Mr-What/Tetra3D/doc/Notes/NOTES.md

# Tilted Delta Development Notes
[Calibration Log](https://docs.google.com/spreadsheets/d/1F8SSiFC5vxzJGwmjgO5lJFe-6YIsopfEGAam5U8VZzw/edit?usp=sharing "Calibration Log")

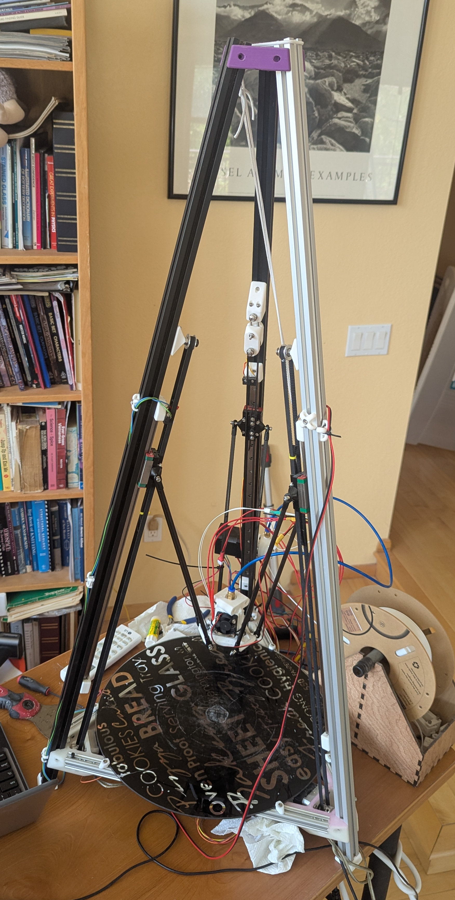
[picture p1: doc/Notes/tetrahedral3Dprinter.jpg]
Tetrahedral 3D printer Initial prototype, circa Jluy 2026


## Added tilted_delta kinematics to klipper
Initial build had a switch mounted on effector, which could
be considered to be a zero offset bed probe.
New kinematics got running in Klipper.
[Bed probe running under Klipper](https://youtu.be/T_cUYRJ55_Q "Bed probe running under Klipper").
I am maintaining a [branch of klipper](https://github.com/Mr-What/klipper/tree/tilted-delta-kinematics-dev "tilted-delta-kinematics-dev branch of klipper") with the tilted_delta kinematics.

## COTS effector trial

Initial build was using a COTS effector
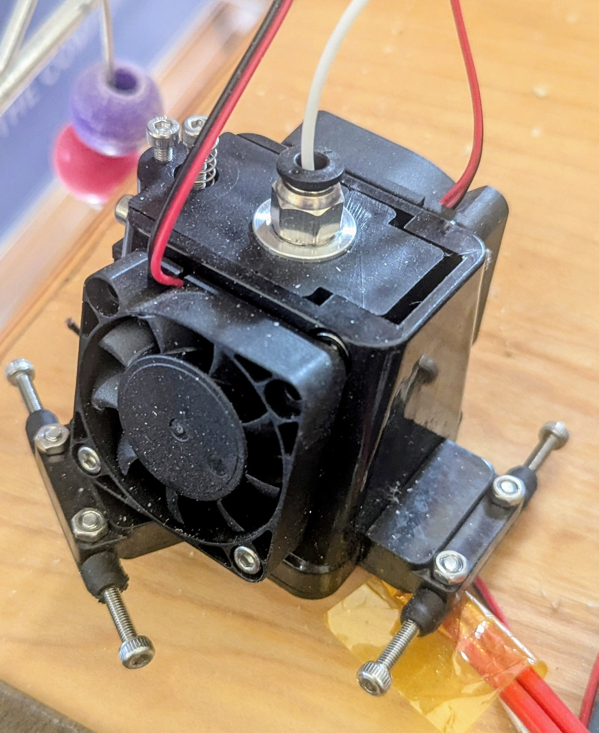
[picture p2: doc/Notes/RostockHotEnd.jpg]
COTS effector COTS Rostock/Kossel toolhead

where the hot end was mounted with a hinge, and pre-loaded with a spring.
This was not repeatable enough to use for a bed probe.

## Experimental Kinematic Mount hot-end probe

Placed hot-end on a kinematic mount,
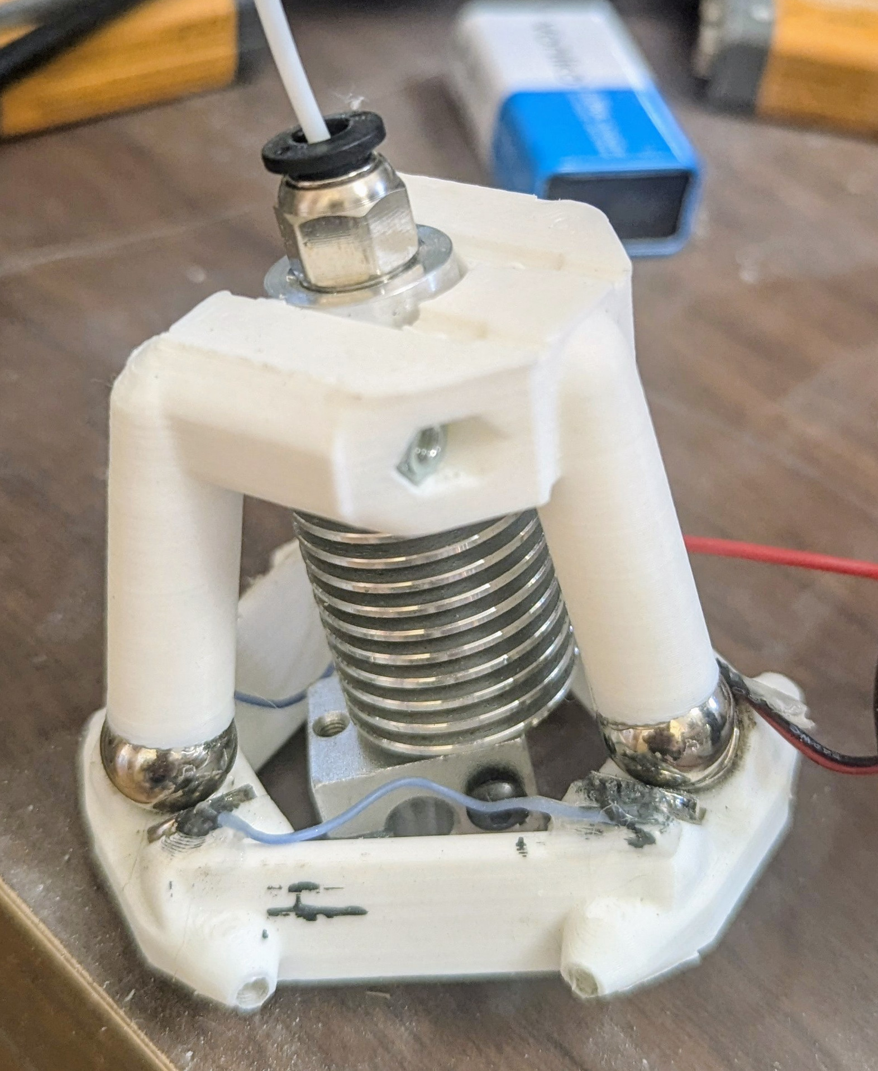
[picture p3: doc/Notes/kinEffector1.jpg]
hot-end on a kinematic mount

which was wired to detect when contact is lost on any of the six contact points.
This was made with parts on hand.
Never complete as a print head.

It seemed to work for a while, but with unpredictable results.
I measured that it took about 400g-force to release the kinematic mount.
I think that the printer is likely to flex and settle given this much force, and I expect that it gave different readings depending on probe location.
I also noted that the first probe or two were often very different to subsequent probes, which did converge.
I think that the frame stretches and moves for the first two probes before becoming repeatable.

probe pattern

Then I got a problem where probes got worse and worse as time progressed, then it would fail upon detecting a bed crash.
tilted up towards tower A as probes continue tilt gets worse over time

I installed a traditional limit switch with offset to the nozzle.
I saw the same problem.
It took a long time for me to figure out that something was wrong with stepper A.
I marked the belt and pulley at location (0,0,150).
I then ran a probe until it stopped on bed crash.
I commanded it to return to (0,0,150), and noted that the belt was around 12mm from the marked position for (0,0,150), which is very close to the amount of error needed for a bed crash.

I replaced stepper A with a slightly higher torque one, and this problem seemed to go away.
reopeatable probe pattern

Having already developed kinematic mounts,
I completed the design to hold hot end on a kinematic mount.
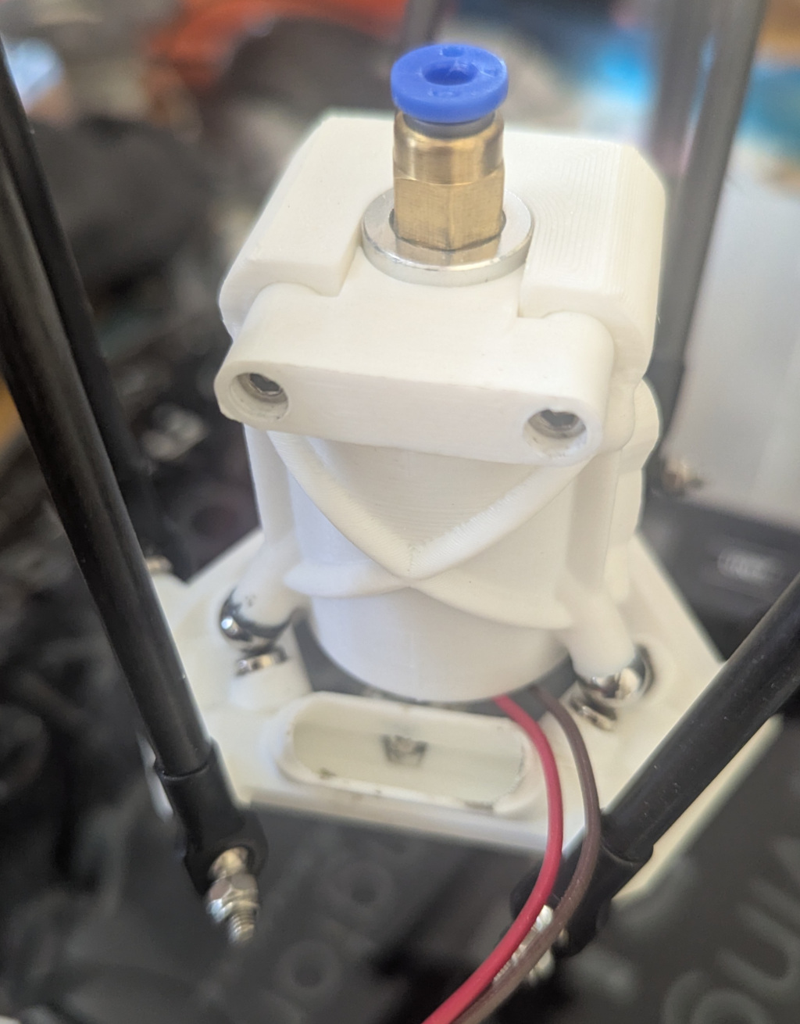
[picture p4: doc/Notes/kinEffector.jpg]
hot end on a kinematic mount

This effector has a removable probe switch and a kinematic mount for the hot end, which can be wired into a bed probe.

### 260715

I have not yet wired new complete kinematic hot end probe,
but I ran a pressure test.  It got up to about 500g, then jumped down to about 450.  I think that might be where contact was broken.
As I kept moving down, I saw it varying from 350 to 400.

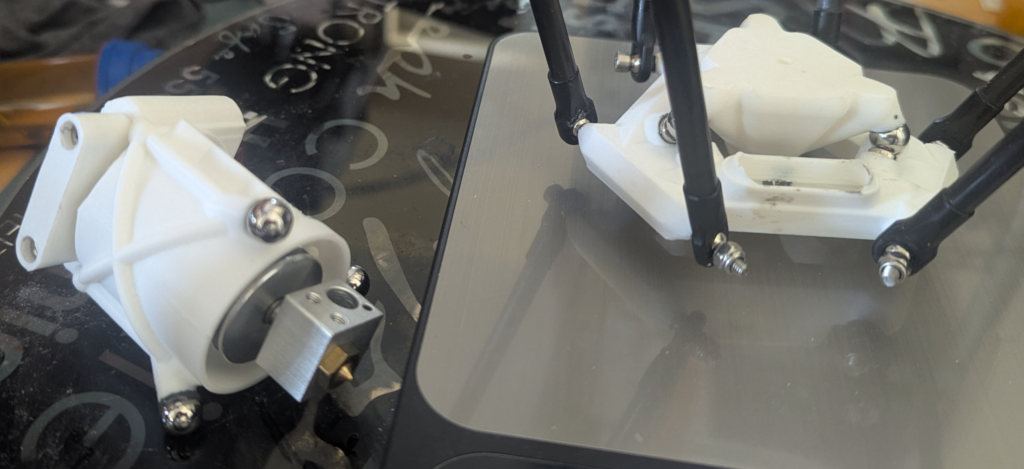
[picture p5: doc/Notes/kinProbe+hotend260715.jpg]
Kinematic probe and hot end kinematic probe with hot end removed


Repeating with the proposed proxy probe, which has likely 306 or 304 balls as opposed to 440c on the complete nozzle assembly, I think the release force is perhaps a little over 28g.
I don't know if I actually saw the release force, since it went from 0g to 28g in my shortest step of 0.025mm.
The measured force stayed about the same from there.
The mass of the probe is 16g, so I think I was seeing that
plus about 10g of magnetic pre-load. 

### 260720

Noted belt slip on stepper A, even after new motor.
In retrospect, I should have known.
Marked belt and pulley position after `G28;G0 X0 Y0 Z150`.
After a run, then `G0 X0 Y0 Z0` noted that dots did not align.
After another `G28` dots aligned on the idler but not the pulley.
The only way this could happen is if belt slipped.

Cleaned pulley, replaced belt, and installed new
idler tensioner.
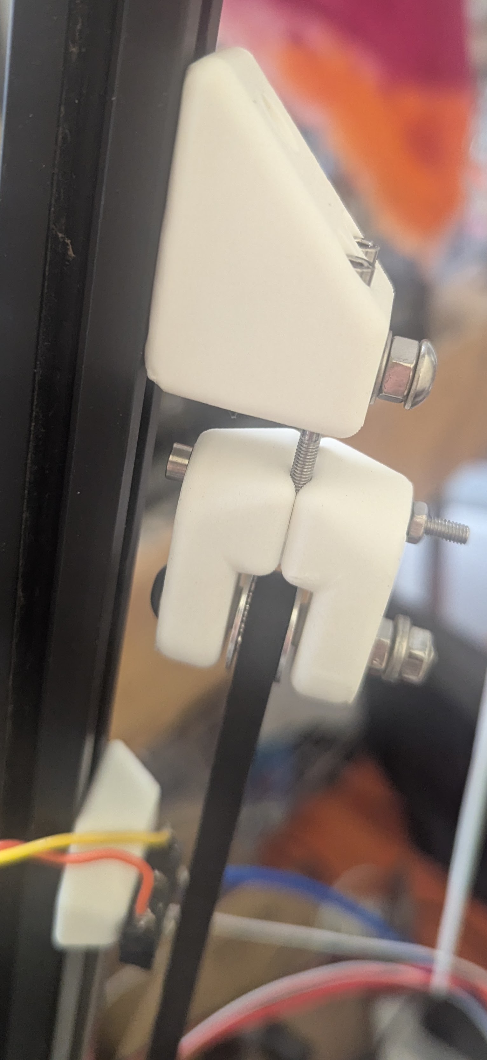
[picture p6: doc/Notes/adjustableIdler260720.jpg]
Adjustable Idler Tensioning Idler Mount

I obtained a decent probe using switch.
repeatable probe Probe repeatable, but significant tilt
It appears to be a clean tilt, indicating an error
in stepper A endstop position.
This is expected, after replacing much stepper A hardware.

Ran with zero offset setting.
Current switch offset measured at (0,-10,-2.2)
from nozzle on kinematic mounted hot end.

I plan to apply offset adjustment in analysis code.
It is not clear that typical offset application is
the best way to go with a delta.
Errors are often X-Y dependant, primarily due to un-modeled
effector tilt.
It might be better to assume bed probe is at commanded X-Y,
and accept that there will be a small Z error for the offset.
We know that we are primarily measuring build imperfections.
The plate could be assumed to be flat, but tilted to adjust.

### 260721

Could not get repeatability with light kinematic probe.

I asked perplexity for what ball materials might be available between the very strongly magnetic 440c,
and the weak magnetism of my light probe, likely a 304 or 316.
It suggested a common carbon steel, like 52100,
or ferritic stainless, like 430.

Claude notes that magnitism drops significantly with a small gap.
However, I still need conductivity, and hardness.
Perhaps I can fabricate removable (or wired) non-magnetic face covers.

### 260722

Cleaned drive pulley A, new belt, and new adjustable belt
tension devic
Did a bed level probe,
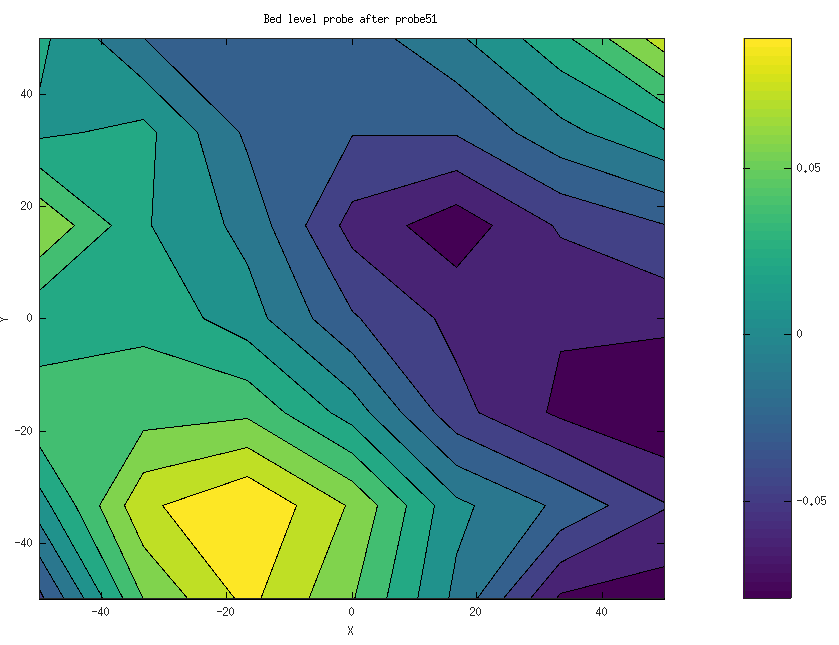
[picture p7: doc/Notes/bed51.png]
bed level probe bed level probe after probe 51

 and was able to print test pattern.
 
 ### 260724
 
Was able to do some test prints.
We need significantly different parameters for eSun PLA+ vs elegoo PLA+.
Got some decent small prints with elegoo.
Demos for Quelab re-opening tomorrow.

### 260727

Trying to get light probe as close as possible to
actual hot-end toolhead.

#### Bed Probes at (0,0)

| | |
| ---|--- |
| Nozzle catches paper | -0.425 |
| Light probe catches paper | -0.450 |
| Nozzle probe | -0.571 |
| light probe | -0.516 |

I think it makes most sense to base the offset
from where the light probe triggers to at or
slightly below where the nozzle catches paper.
How many microns thick is typical newsprint?
I am always confused by the sign for the offset,
so our offset should be +- 0.091.

### 260730

Printer was demonstrated at Quelab re-opening party
on 7/25/2026.
Work is continuing at home.

I have been having issues with the kinematic probe/sensors working.
It seems that they can reduce or go away by cleaning the contact
surfaces with isopropyl alchahol (IPA).
Acetone might be better, but it also might melt IPA or PETG.

bed mesh bed compensation probe
<!-- ![bed mesh](./bedMesh.png "bed compensation probe") -->

I am re-running probes on a bed that has adhesive on it
to print without a bed heater.
This might raise the bed surface about 0.1mm in a random
fashion.
I don't think this will be a problem for the calibration.
It is just a little extra noise.
I had been experimenting with weights on the probe to improve
contact.
I don't think it really helps.
It seems to be running OK without weight after cleaning.
The problem with weight, is although it improves downward
preload force, it is also a challenge to move laterally to
the lowest energy position.
Using the weak ferromatnetic balls, likely 304 stainless or 316,
they may not have the strength to center a weighted probe.
The problem with probes triggering premature might be
helped by cleaning contacts, reducing friction on ball to magnet face.

good probe good cal probe

### 260819

Back from renovating rental. Note:
```
   Z_offset = (Z where probe triggers) - (Z where nozzle touches bed)
```

### 260820

New switch probe.
Z at bed keeps going up, at least for a while.
Initial nozzle touch at 0.225mm, then probe went up by
perhaps .06 on repeated probes, seemed to settle at .87.
Repeat nozzle touch at .27

Re-calibrated with new probe.   Results OK.
18 parameter optimization converged.
stable results.

### 260822

Got decent bed probe:
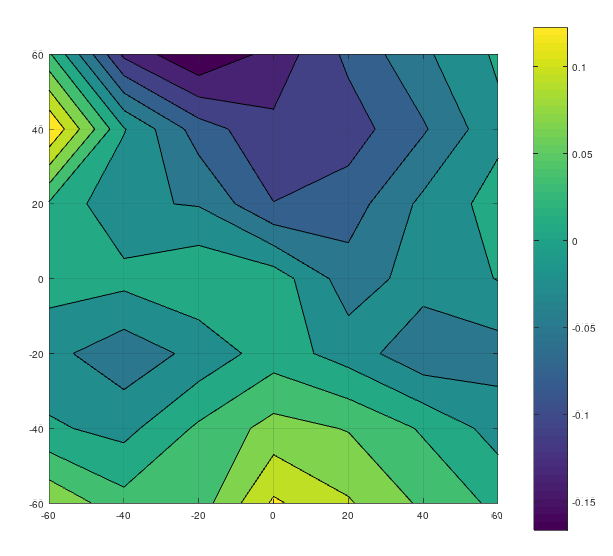
[picture p8: doc/Notes/bedMesh63.png]
bed63


XY calibration is problematic.
Printed 100mm test "cube".
Sides not straight or square.
Vertical looks pretty straight and square.

I don't want to spend too much time calibrating
this configureation.
I think the next step is to move to the shorter
arms, and go through the whole calibration process again.

### 260906

Got new shorter arms a while ago.  180mm.
They usually sell these by carbon tube length,
so 180mm would be around 210mm arm length.
Re-ordered tubes and M3 heim joints to make my own.
Re-installing old arms, will need to re-calibrate.

Printed new mounts for tghe BiQU microprobe, and the Mellow Multihead Zero device.

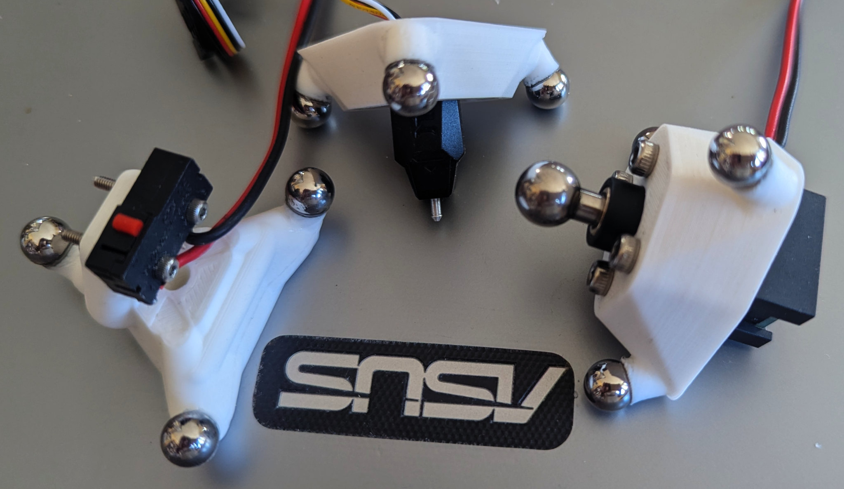
[picture p9: doc/Notes/probeTools.jpg]
New probe toolheads


### 260907

Got a very good probe from the Mellow Multihead Zero probe.
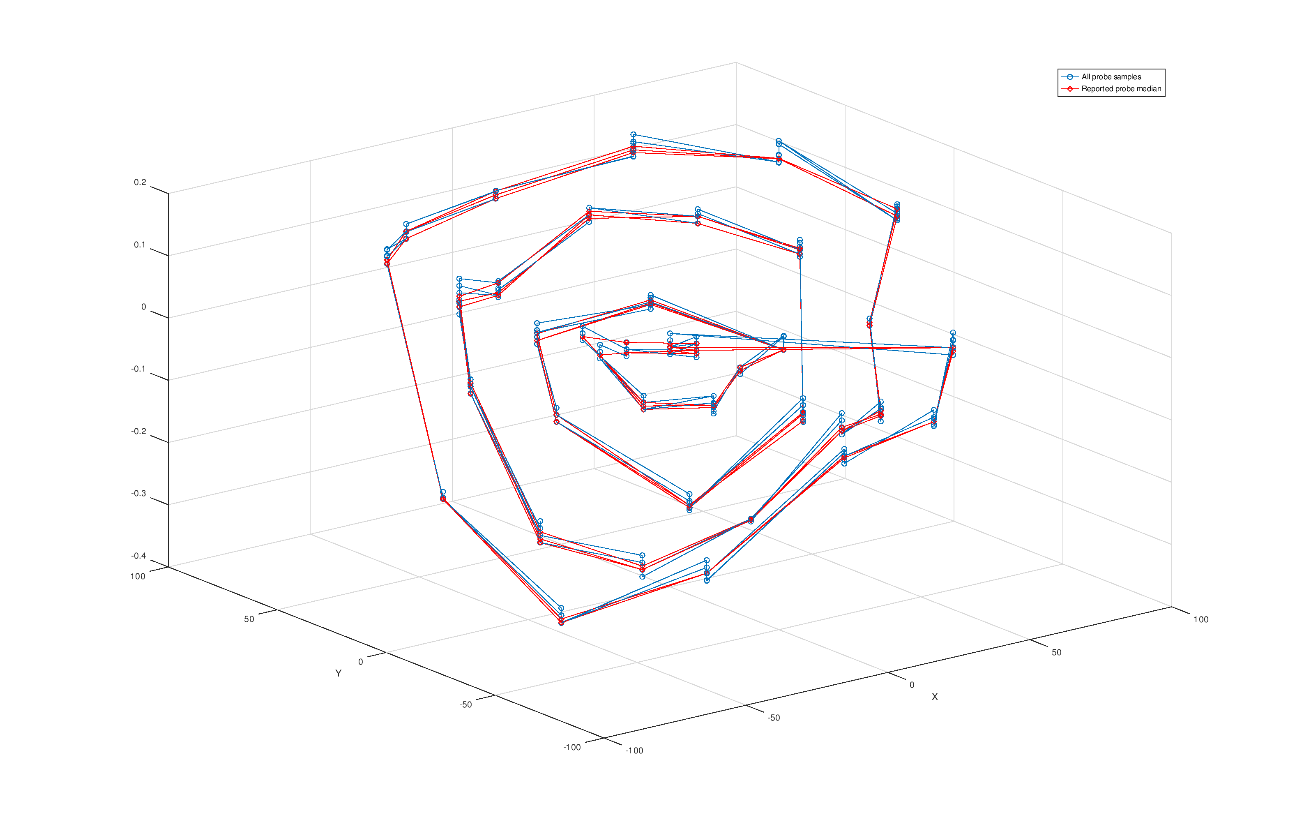
[picture p10: doc/Notes/probe64.png]
probe 64

Google is down, so notes on probe:

calAE:
```
     median=-0.05;
     StDev =  .123;
     err=0.048139;
     endstop=[480.7930, 475.5129, 476.7947];
     arm=[285.942075 , 284.944120 , 285.907718];
```

This was after re-assembling arms, so they were certainly swapped.
I expect to see change in arm settings.
Previous params:
```
   delta_angles = 209.787   330.137    89.931
   delta_radius = 169.49   169.30   169.23
   arm_lengths =  286.04   285.97   286.03
   tilt_radial =  13.775   12.526   12.783
   tilt_tangential = 0.031834  -0.346611   0.705373
   position_endstops = 480.63   476.64   477.15
```

after probing with these updates, we get:
```
z stats: [median, mean, SD] = [ -0.005 , -0.002 , 0.0510 ]
```

For future reference, probe a bed mesh like :
```
   HOME
   BED_MESH_CALIBRATE PROFILE=myMeshLabel
   SAVE_CONFIG
   ...
   BED_MESH_PROFILE LOAD=myMeshLabel
   BED_MESH_OUTPUT  # I don't know if this works
   BED_MESH_CLEAR # turn off bed level compensation
```

Results with above arm-length and endstop update were:
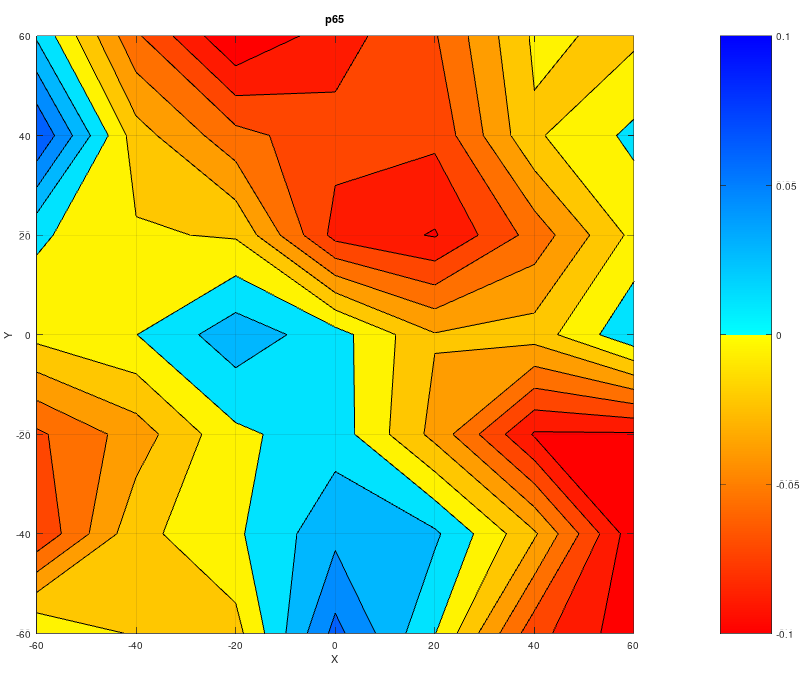
[picture p11: doc/Notes/bedMesh65.png]
bed mesh 65


### 260908

Made cal print, and re-calibrated.
To use BiQu probe, I will need full 5-wire connection:
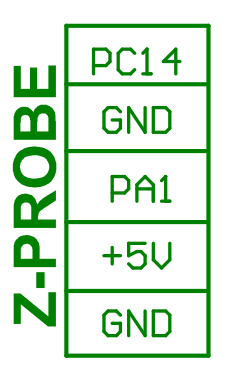
[picture p12: doc/Notes/Z-PROBE_pinout.png]
Z-Probe pinout


aargh.  Standard heim joints do not have enough side-to-side movement to be used for delta arms!!!

### 260909

measured cal print 066.
did probe066.log
Has bed Z median at -.6.
Tested paper touch at 0.55.
Probe at 0.551.
This does NOT seem to change with z_offset setting?!??.
How did print work?  We command to Z0, but bed is at Z-.6?

### 260911

Confusion about probe offset.
Starting (mostly) all over.
Loaded with parameters estimated from probe066.
It appears that logged probe values are estimated
cartesian location of nozzle.
They DO contain the probe offset.
Re-running with probe offset 2.35.
Reported probes are median 0.16.
measured probe touch at 3.24.
measured nozzle touch at 0.67.
offset check = trigger - nozzle touch = 2.51

aargh.

Running probe 68.  offset = 2.35.

### 260915

Missed some logs earlier.
Got everything running.
Smooth rough-cal, then print, then full-cal.
worked fine.

Had some trouble with nozzle crashing into bed.
This did not happen when typing gcode in the console.
Added some G4 P500 pauses in the PRINT_START macro, and
it seemed to go away.

Pretty decent test prints.
Still a bit worried about machine part accuracy,
but may be as good as we can expect from this printer.
Try some pre-load rubber bands to reduce backlash?
I see some backlash on PROBE_ACCURACY.
The first few probes drift a bit, then go more random.
Indicates parts are flexing and settling for a bit
before it gets repeatable.

### 260916

Noticed loose screw on frame bracket.
This may have been the cause of changing results for a long time.
Tightened up, and re-calibrating like new, unknown printer at probe78.
Printed cal print and probe080.

### 260917

wrote a summary of my calibration process.
This one worked well with a full calibration,
but that is not dependable.
suggest series of parameter subset cals instead.

After re-calibration, bed mesh is:
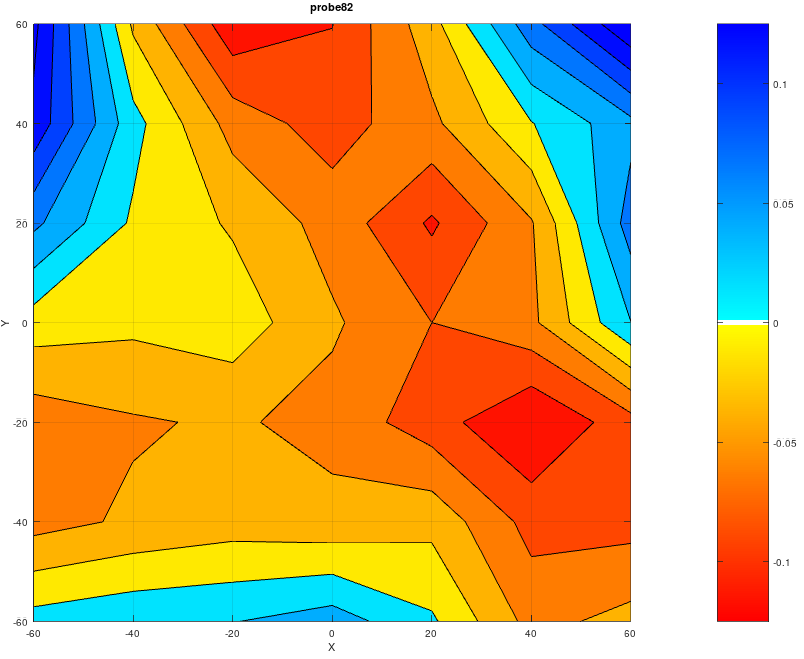
[picture p13: doc/Notes/probe82.png]
bed mesh 82


### 260919

Crashed into endstops, reason unknown.
One was knocked loose.
Installed new idler tension mount on one tower.
Tightened up all endstops.
re-calibration of endstops looks good.
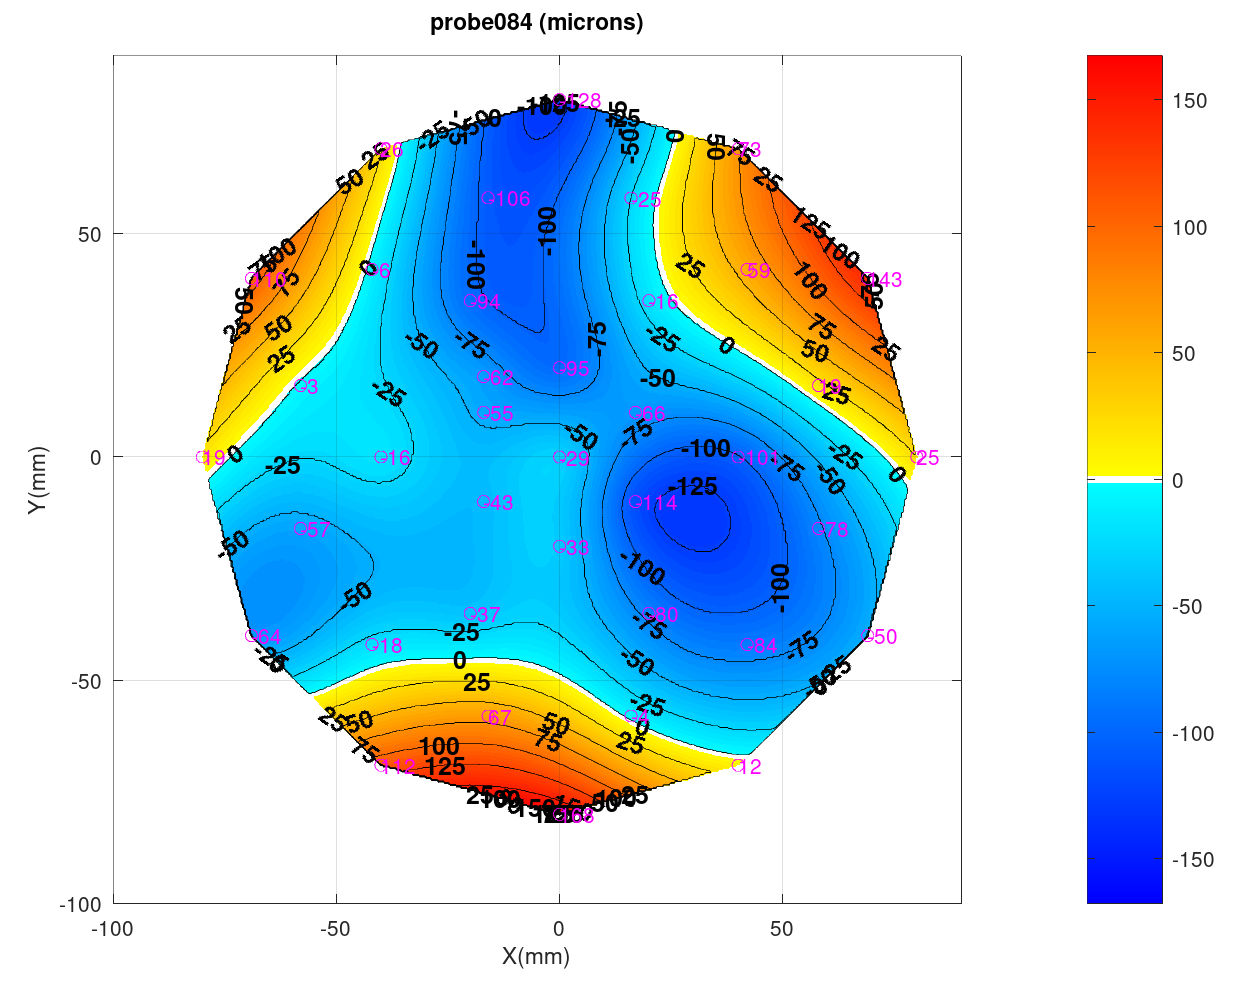
[picture p14: doc/Notes/probe84.png]
probe84

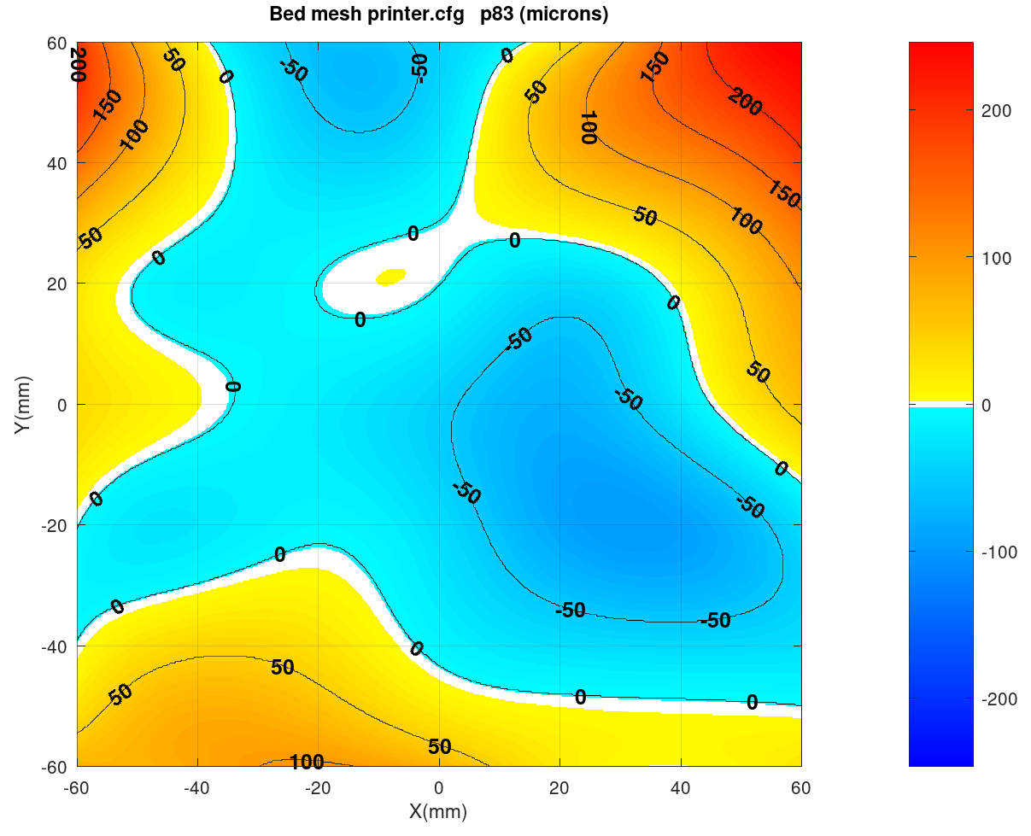
[picture p15: doc/Notes/mesh83.png]
Bed mesh p83


Seeing significant backlash.
Line segments are drawn on the X and Y axes, 
but with approach to each segment from opposite direction.

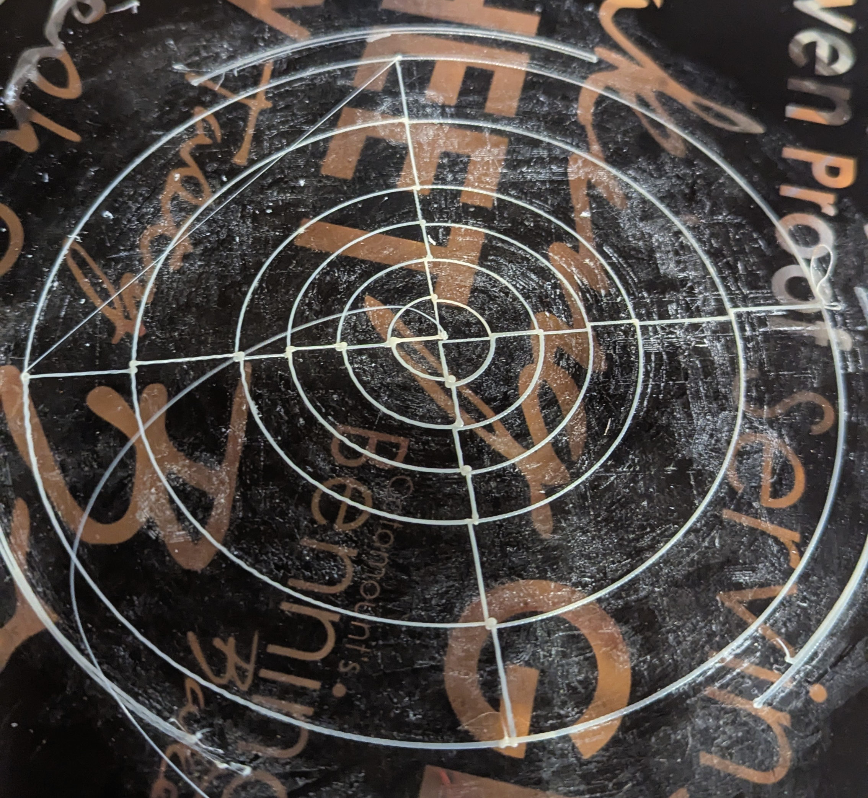
[picture p16: doc/Notes/targetBacklash.jpg]
backlash on target test


### 261002

Working on calibration plate.
Tried machining, but it's a lot of trouble.
Trying to probe 3D printed plate, printed on a wall-calibrated
Cartesian style printer.
With the Mellow MultiHead Zero probe, I can see some
sideways deflection on the probes.
This will make it difficult to use these probes for a
reliable bed probe estimate.
I will fit probes with a 2D parabolic polynomial,
in the hopes that any odd sensitivities from sideways force
will make probes look like an odd-shaped poly,
but with a reliable center.

### 261004

got plate probe runnuing.  checked in.
Next: add plate measurements to tetraFitErr.
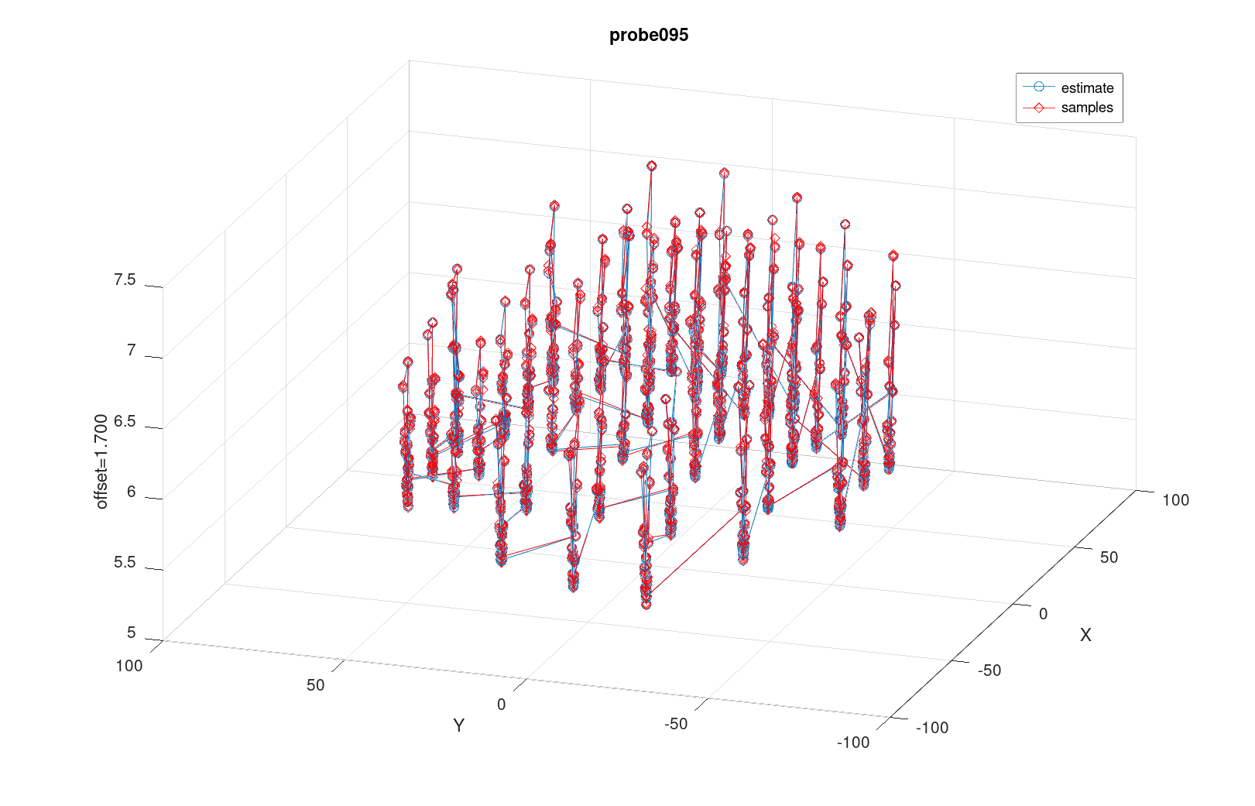
[picture p17: doc/Notes/probe095.png]
Probe and search for bottom of dimples

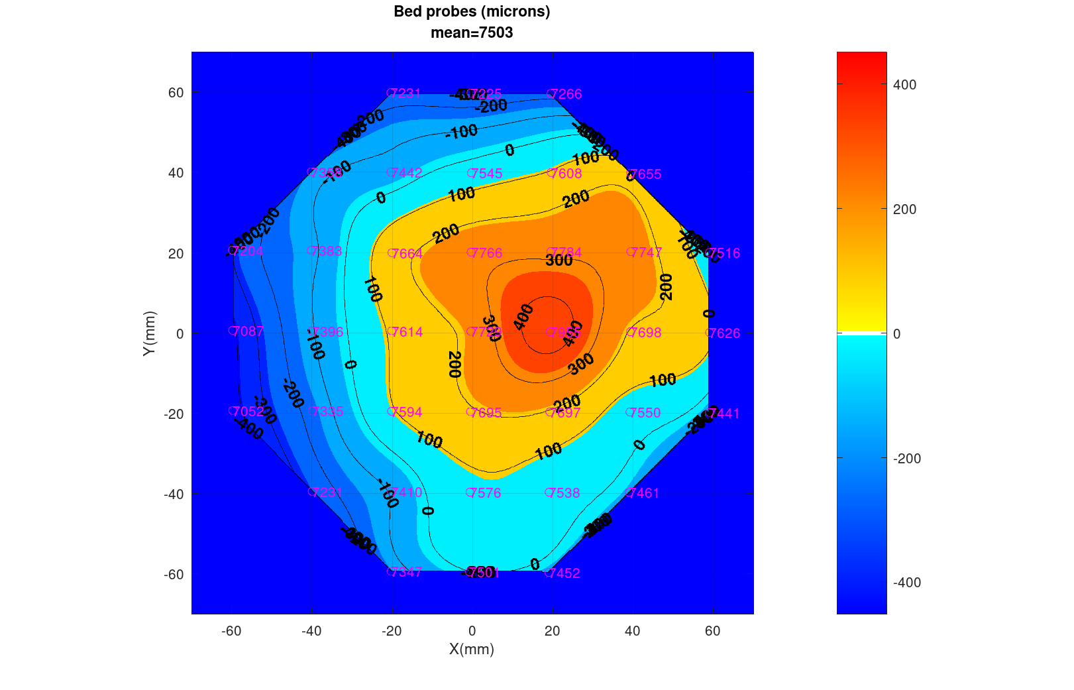
[picture p18: doc/Notes/probe095contour.png]
Estimated dimple minima

### 261005

More plate probes.
From drawing, probe triggers on plate 4.17mm higher than bed.
Probes are returning 5.2.  Not sure why such a large discrepency.
Note that dimple has a very stair-step profile.
Not many layers deep, but quite wide, simulating a 150 degree
router groove tool.
New, shallow dimple plate measured nominal 120mm on center dimples
at 119.3mm.  Diagonal fairly close, hence square.
I might add a scale option to ideal dimple locationsBoim1248

It looks like ```FIRMWARE_RESTART``` is no longer re-starting ```klippy.log```.
I may need to add to my ssh command to filter the file more.
```
n=$(grep -n 'Start printer' klippy.log | tail -n 1 | cut -d: -f1)

if [ -n "$n" ]; then
    tail -n +$((n + 1)) klippy.log 
else
    cat klippy.log
fi
```
 
 Changed ```tail_klippy_log.py``` to include last 5 lines before
 start of config echo, when available, so we can archive start time.
 
 ### 261006
 
On printed cal plate, large ball seemed useful below .1mm x-y movement.
D2HW mostly useless below .25mm.  It was tracking layers, stair steps.  bottom was flat.
At least on printed cal plate, large ball tip of MMH0 works much better.

Either way, with parabolas, cones, radially symetric or not,
I'm getting a lot of bad fits.
Lowest probe clearly near vertex, but estimates not close to low probe.
Try more complicated error metrics?

Call lowest probe in cluster xMin,yMin,zMin.
Use z err.  err = z-zMin up to some radius threshhold.
Then do a linear fit.
Threshhold and linear fit slope automatically computed, but ignored.
Just quantities computed along the way.
Parameters p(3) = vertex.

### 261011

Changed plate probe approach.
   1. Probe cardinal points around expected center of dimple
   2. compute a better estimate of center of dimple
   3. probe standard pattern of points around rough estimate of center
   4. In analysis, look only at the standard pattern of probes to estimate dimple vertex.

This prevents an over-weight to the estimate from an
area where there were there were more probes.
It is also much easier to analyse.

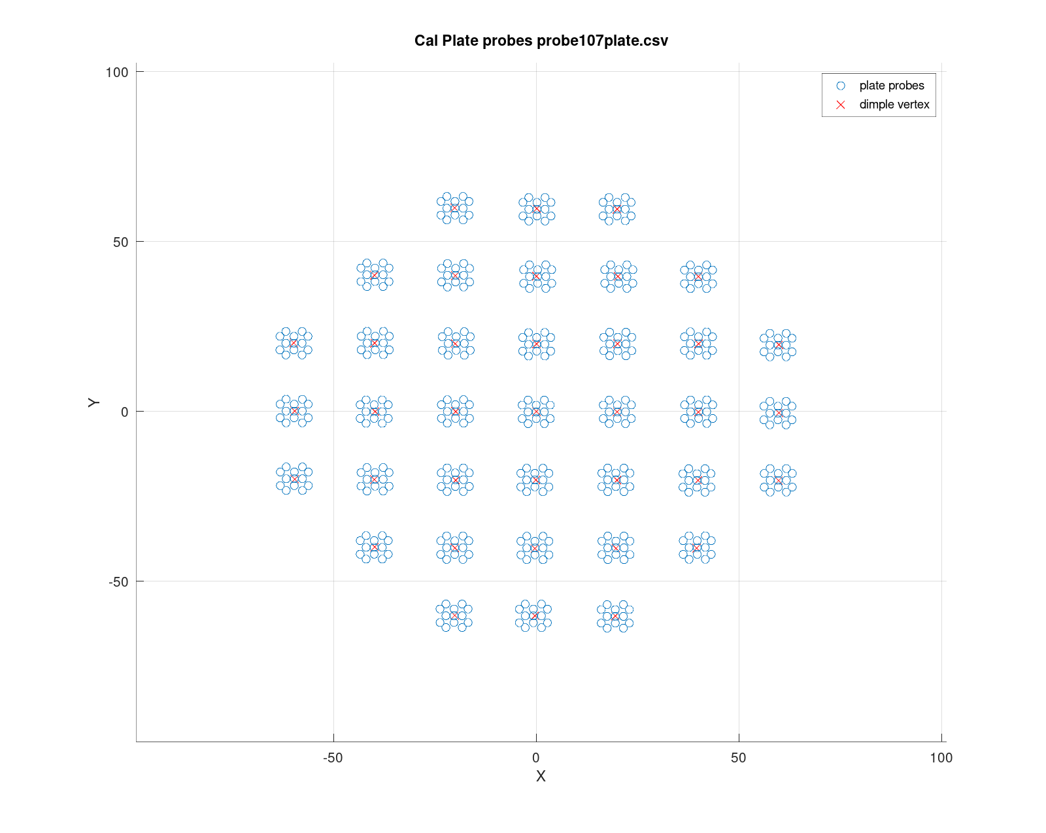
[picture p19: doc/Notes/probe107.png]
Neighborhoods around dimple vertices

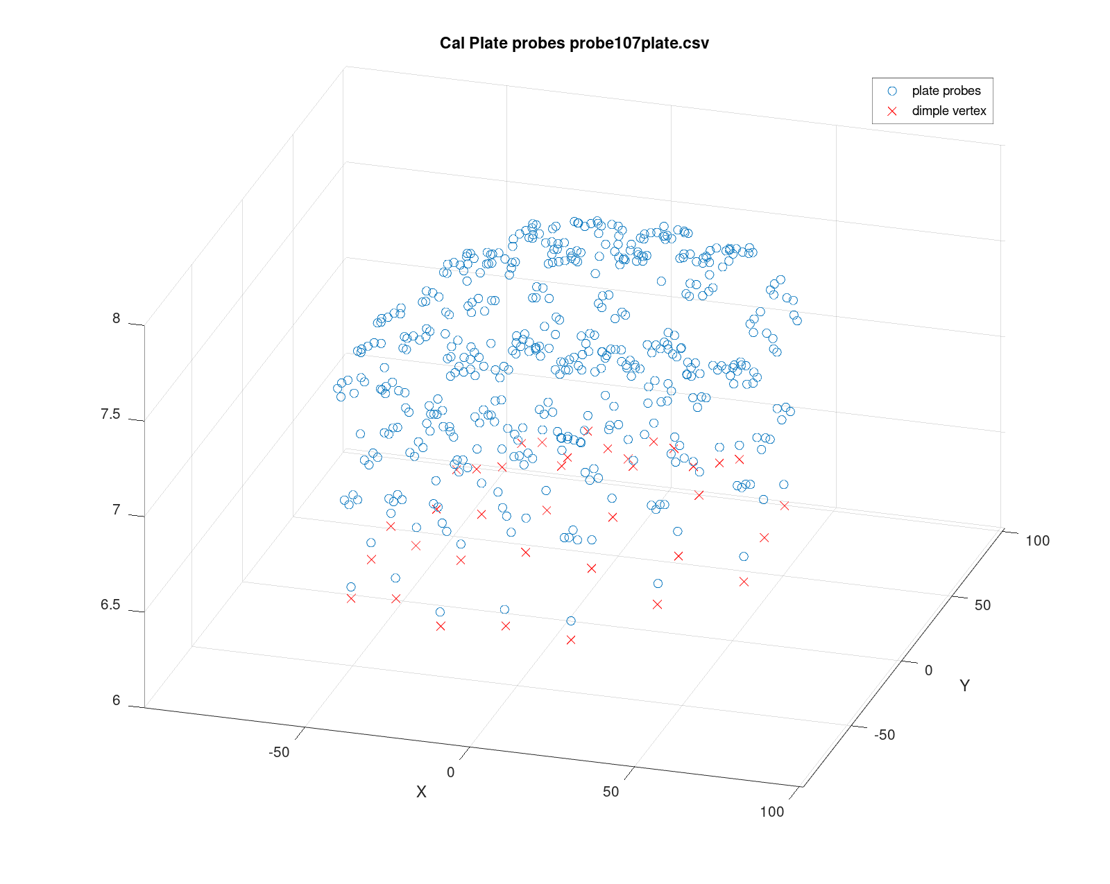
[picture p20: doc/Notes/probe107side.png]
Neighborhood height around dimple vertices


Refactored some code for this approach,
and new naming standard where functions specific to klipper
start with ```klip```.
Functions specific to tilted_delta model start with ```tetra```.
I think the hump pattern to the plate probes is likely
to be warping of the 3D print.

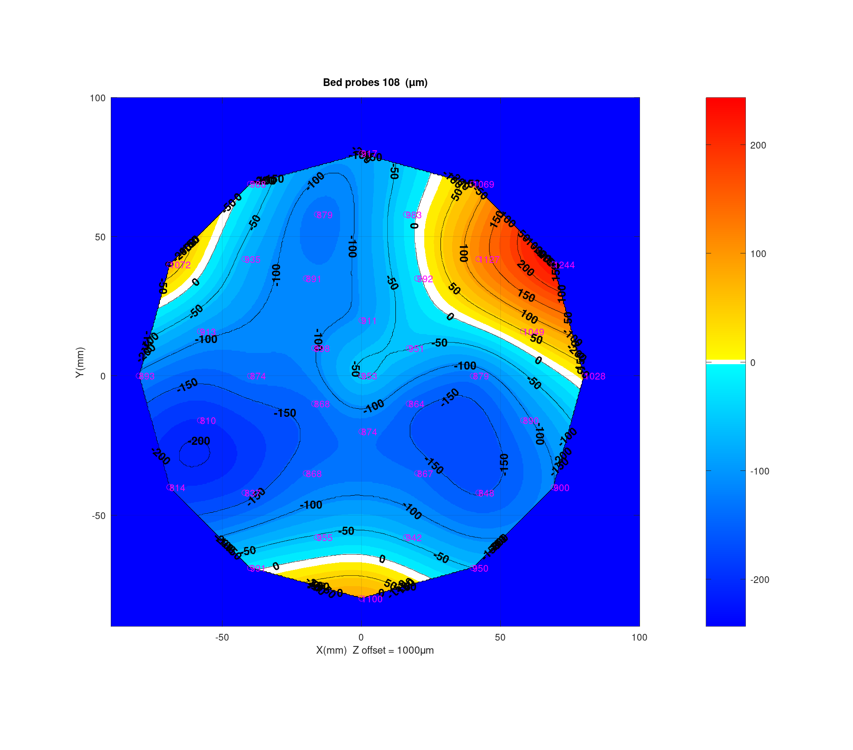
[picture p21: doc/Notes/bedProbes108.png]
bed probe 108


The bed probe looks about as good as they are getting at this stage.

### 261012

Processed bed probe108 with plate probe107.
Got significantly different parameters, but after
entering them I got the flattest bed probe109 ever.

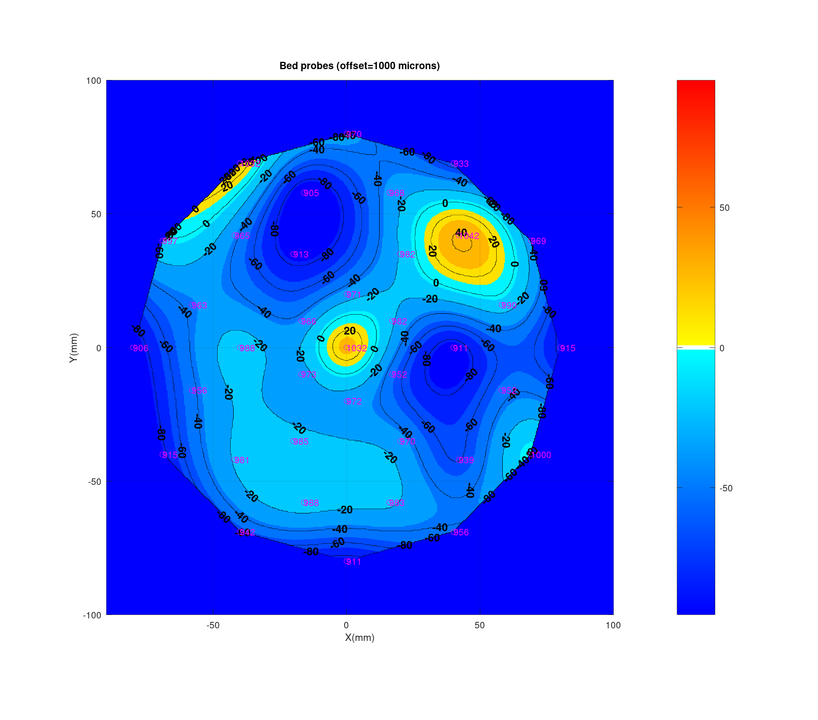
[picture p22: doc/Notes/bedProbes109.png]
bed probe 109


Unfortunately, the scale was terrible, and there were
bugs in the error computation for the plate.
ignore 109.

### 261014

Got a cal update using MMH0 probe, bed probe112,
plate probe111, using param update from 108.
Pretty good looking results, but print
measurements still not great.

Got weighted rigid trasform coded.

### 261020

Having trouble on cal, using plate.
I have gotten a result where the bed probes as tipped,
usually about -0.2mm to 1.5mm, tipped up towards tower A.

I re-did the bed probe using parameters from last reasoable cal from probe 128.

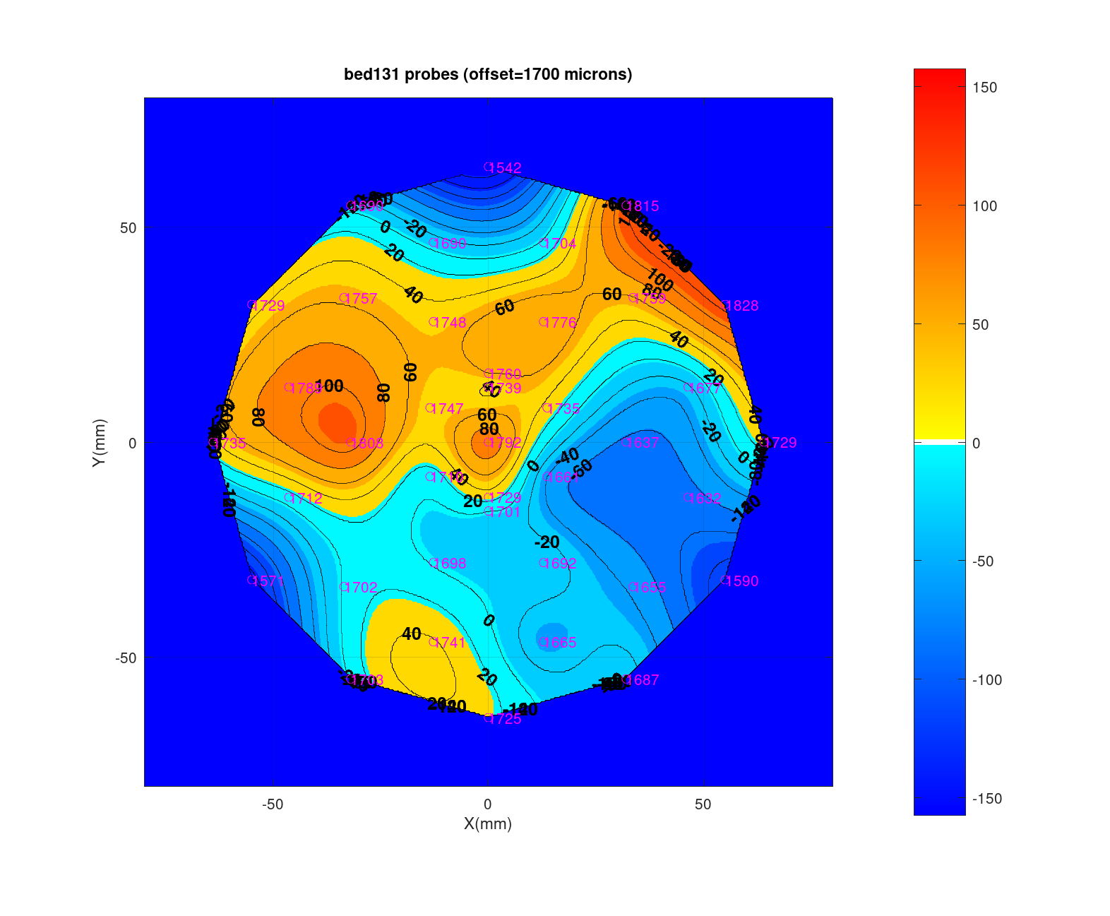
[picture p23: doc/Notes/radialBed131.png]
bed probe 131


After a bed-only on 131 probes, AE then ZTE,
I got some reasonable parameters.
Bed probe 132 was slightly better, but not significant.

However, after some confusion, I did probe 133 with
same parameters, and got that nasty tilt up towards tower A.

Not sure what is happening.

Changed belt tensioner on tower A, although I don't think
that is the likely culprit.

Repeat probe for 134, but I expect some issues, especially
with endstop A, which has been worked on.

### 261025

Messing with calibrating new shorter arms.
Wrote unified calibration procedure.

### 261027

measured envelope.

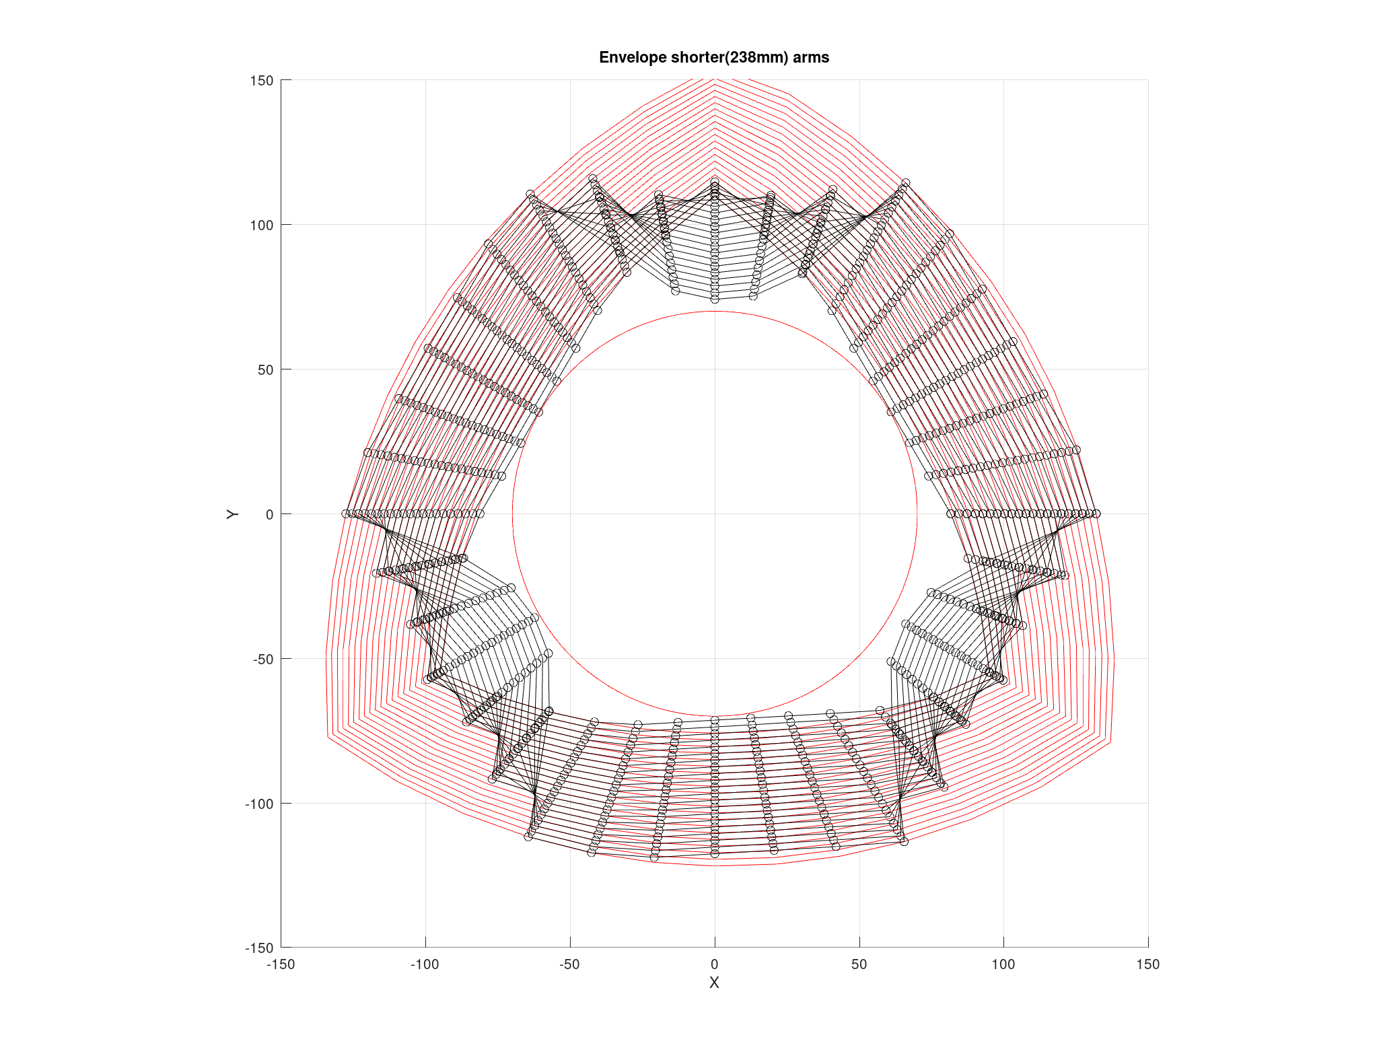
[picture p24: doc/Notes/envelopeXY.png]
envelope above

Plotted 70mm radius circle on bed.
Red lines are where even with no pose limitations,
those points could not be reached.
Black is limit arm pose to outside of 11.5 degrees from tower
or it's radial perpendiculat; and no more than 37 degrees to the side.
The sideways freedom of the Heim joints is very limited.
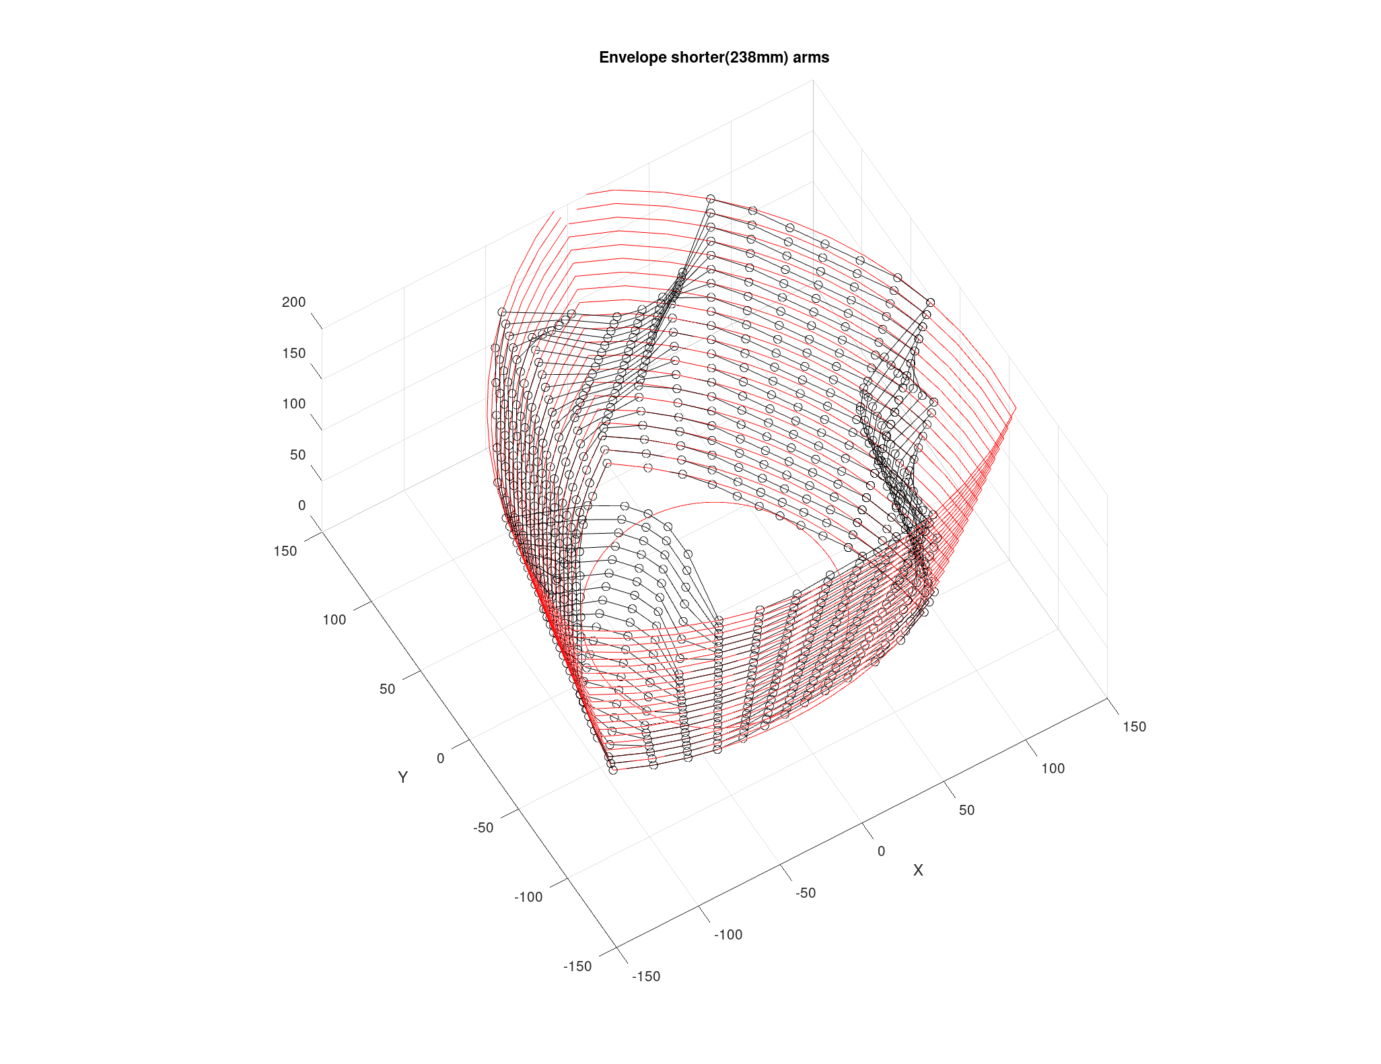
[picture p25: doc/Notes/envelopeA.png]
envelope

You will note that the envelope gets "pinched" as you get
farther from the bed, and the towers are getting closer.

From the computed envelopes, I'm getting a max
radius of 110 for the 290mm arms,
and 70 for the 238mm arms.
Given current frame, optimal arms for largest
bed level envelope is 281mm, max bed radius 112.6mm.

For my nominal design, the maximum circular envelope on the bed
as a function of arm length is 112.6 with 281mm arms:
radius at bed circular envelope at bed vs. arm length
My 290mm arms are close enough, but the traxxas ends may be
a source of slop or backlash.
The longest arms I have with heim joints are 238,
which I am using now.
Some minor improvement, but not a lot, at the
cost of a significant reduction of print area at the bed, 70mm vs 110mm.

###261029

For comparison, on a delta with the same tower base locations,
the optimal arm length is 284mm, with a circular print envelope radius 113.4mm.
delta radius delta print envelope for towers with same delta_radius

### 261105

Wrote tetraPlotPlateFit.m.
Found that best fit scale to plate was 100.62/102.
However, since we are trying to calibrate scale
on printer, we should not use this in calibration.
Stick with measured 101.3/102.

plate 141 with bed 143 had very similar answers
for both AZT and RZT.
Check if RA improves scale?

### 261106

Started major refactor, change main parameter sub-strucuture in tetra data from .p and .k to .cfg and .kin respectively. 
Single character names for central parameter strucures was
a bad choice.

Wrote new plotting routine to visualize plate fit error.
```
function q = tetraPlotPlateFit(meas,template
                         [,w,mag,rem,reScale])
 pm  -- plate measurement, dimple vertex X,Y locations
 tp  -- template positions of dimples
 w   -- weights (default, even weighting)
 mag -- Magnify display of residual error by this much in plot
 rem -- remark for title
 reScale -- re-scale for best fit (false)
```
plate fit error XY error to calibration plate

Had trouble getting network running on RPi at explora.
It might be better to use my hotspot in the future.
```
nmap -sn 10.137.135.0/24
```
should find the RPi on the BoimPxel network.
If your machine does not have nmap,
you can ping the broadcast address,
then the RPi should show up on the arp table
```
ping 10.137.135.255
ping -b -c 2 10.137.135.255  # might be better
arp -a
```
My procedure to set things up away from home will be:
   1. enable hotspot BoimPixel
   2. Boot RPi, it should connect
   3. find RPi with other computer
   4. ssh in, and edit /etc/wpa_supplicant/wpa_supplicant.conf to add another network, if you don't want to use the hotspot.
	   * reboot, since I'm not sure if something like ```(ifdown wlan0;ifup wlan0)``` will work.
	   * ```sudo bash -c "ip link set wlan0 down; sleep 30; ip link set wlan0 up"```

Remember, cal process: 
  1. set extruder temp 230, or what ever is needed for your filament
  1. <pre><code> > SET_PATTERN_SCALE SCALE=66```
      > HOME</code></pre>
  1. print hex_outline.gcode
  1. attach plate C to bed
  1. <pre><code> > HOME
      > DIMPLE_PROBE_SET SCALE=17</code></pre>
  1. print probe_plateC.gcode
  1. <pre><code>octave> pattern = 17*hexGrid(3);
     octave> cp = tetraLoadPlateProbe('plateC148.log', pattern, 101.3/102);</code></pre>
  1. print radial_bed_probe.gcode
  1. <pre><code>octave> td = tetraLoadCalData('bed148.log',cp);
     octave> gp = tetraCal('R',td);
     octave> gp = tetraCal('AZT',td,gp,4,false);
     octave> gp = tetraCal('RZT',td,gp,4,false);
     octave> gp = tetraCal('RA', td,gp,4,false);</code></pre>

I could also try putting a little error penalty on how unequal delta_radius or arm_lengths are.
	 
### 261109

Tagged v0.1.  Last version using original parameter set.

After some thought, I realize that base locations
should be a 3 parameter space.
Klipper used a single delta_radius, and angles for
towers A and B, which I think is a good choice.
Tower C is assumed to be at [0,R].
This only makes the assertion that the origin is within
trangle A, B, C.
<strike>Similarly, instead of 6 angles for the tower directions,
I only need to define a point, above the bed,
on the tower axis.
I can use a similar convention.
Since I do assert that the shifted "center" of the top
is within triangle A, B, C at that height, I don't want
to assert the whole height of the tower.
The top center could well drift outside of triangle A,B,C
up where the top radius, Rt is small.
Choose top to be near the top of the envelope.
Then we can describe another set of tower points in a similar manner.
Ct is at [0,Rt,Zt].
At and Bt are at angle DAt, and DBt at radius Rt,
height at arbitrary height Zt ~= top of envelope.</strike>
Nope.  we still need 6 params.  This does not address twist.

Re-work the whole system with new parameterization:
```
[printer]
kinematics: tilted_delta
delta_radius: 169
tower_angles: 210, 330
arm_lengths: 238, 238, 238
tilt_radial: 13 , 13 , 13
tilt_tangential: 0 , 0 , 0
```

These changes reduce the calibration parameter rank from 18 to 15.
