Mr-What/Tetra3D/doc/tetDefs.png

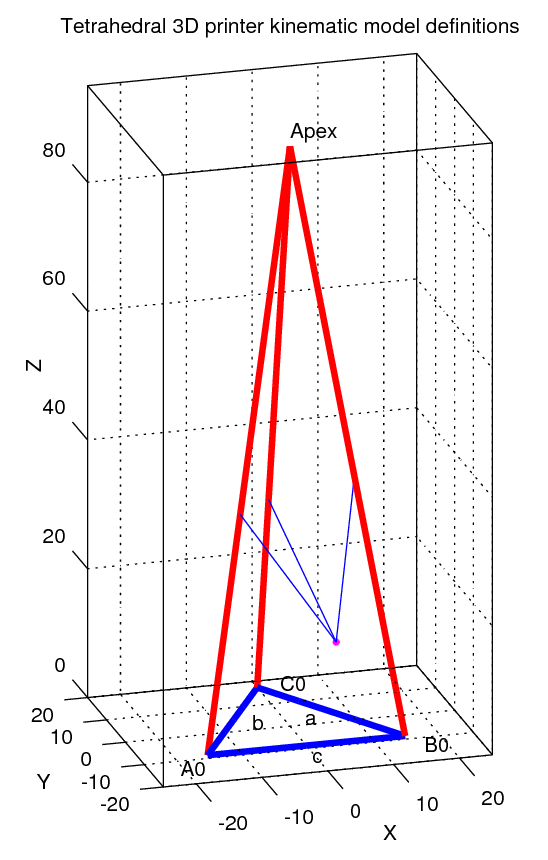
doc/tetDefs.png
