Mr-What/Tetra3D/Drawings/kinMicroprobe.stl

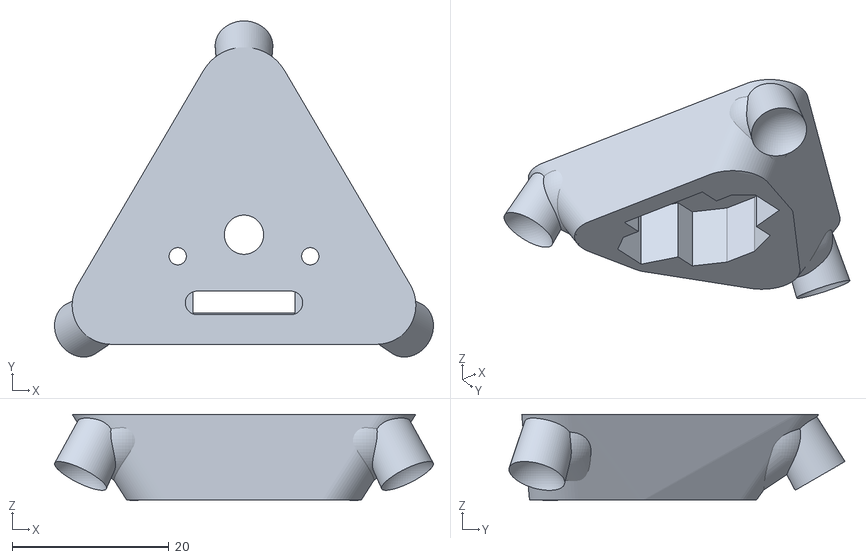
[picture p27: CAD file, 2026-08-31]
Drawings/kinMicroprobe.stl
48.4 x 42.9 x 11.0
