Mr-What/Tetra3D/Drawings/microprobe_v2_mockup.stl

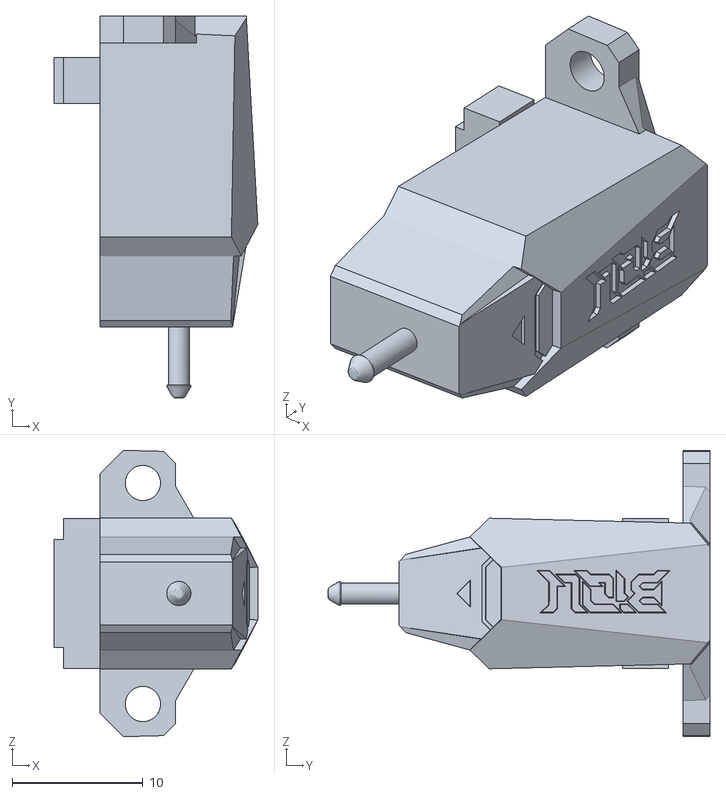
[picture p28: CAD file, 2026-08-30]
Drawings/microprobe_v2_mockup.stl
15.6 x 29.2 x 21.9
