Mr-What/Tetra3D/Drawings/bedClip.stl

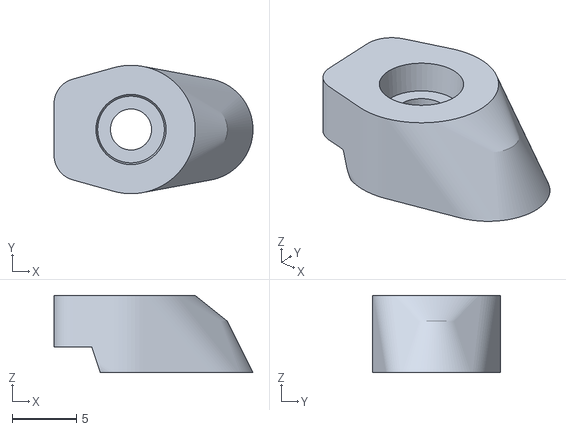
[picture p29: CAD file, 2026-03-24]
Drawings/bedClip.stl
15.5 x 10.0 x 6.00
