Mr-What/Tetra3D/Drawings/kinMountBTTmicroprobeV2.scad

// maxwell kinematic mount for BTT microprobe V2

import("microprobe_v2_mockup.stl");
