Mr-What/Tetra3D/doc/SKR_Mini_E3_v2.scad

//import("btt_skr_mini_e3_v2.0.stl"); // doesn't render
import("SKR_Mini_E3_v2_Case.stl");
%translate([51.3,-26.6,8]) rotate(90)
    import("SKR_Mini_E3_v2.0_Dummy.stl");
