Mr-What/Tetra3D/(list of files, cad)

Other CAD files:
Drawings/configuration.scad
Drawings/endstop.scad
Drawings/frogCarriage.scad
Drawings/nema17.scad
