Mr-What/Tetra3D/KlipperCfg/printer.cfg

# $Id: printer.cfg,v 1.7 2026/05/14 21:07:36 aaron Exp aaron $
# This file contains prototype tetra pin mappings for the
#
#               BIGTREETECH SKR mini E3 v2.0
#
# To use this config, the firmware should be compiled for the
# STM32F103 with a "28KiB bootloader" and USB communication. Also,
# select "Enable extra low-level configuration options" and configure
# "GPIO pins to set at micro-controller startup" to "!PA14".

# The "make flash" command does not work on the SKR mini E3. Instead,
# after running "make", copy the generated "out/klipper.bin" file to a
# file named "firmware.bin" on an SD card and then restart the SKR
# mini E3 with that SD card.

# See docs/Config_Reference.md for a description of parameters.

# This setup is for the experimental tetrahedral 3D printer,
# which uses the tilted_delta kinematic model, available at:
#
#    https://github.com/Mr-What/klipper/tree/tilted-delta-kinematics-dev
#
# The master of this project is intended to track the master at
# https://github.com/Klipper3d/klipper
# The deviation from the official klipper master is tracked in the
# tilted-delta-kinematics-dev  branch of https://github.com/Mr-What/klipper
#
# calibration tools and drawings are in the Tetra3D project:
# https://github.com/Mr-What/Tetra3D

[printer]
kinematics: tilted_delta
# delta_radius: 171.781638	 261110105009
# delta_radius: 169.5318	 261110105715
# delta_radius: 169.5405	 261111110035
delta_radius: 171.7333
# tower_angles: 210, 330	 261110105715
# tower_angles: 210.1029 , 330.7544	 261111110035
tower_angles: 210.1854 , 329.5486
# arm_lengths: 239 , 239 , 239	 261111110035
arm_lengths: 240.146764 , 241.009401 , 239.596418
# tilt_radial: 13 , 13 , 13	 261111110035
tilt_radial: 13.663976 , 13.310034 , 13.510197
# tilt_tangential: 0 , 0 , 0	 261111110035
tilt_tangential: 0.193998 , -0.542009 , 0.099571
max_velocity: 300  # mm/s
max_accel: 800
max_z_velocity: 300
max_z_accel: 800
print_radius: 80
minimum_z_position: -10   # not used in kinematics, but needs to be negative for bed probes, which can be negative Z


[stepper_a]
# 261019133257 position_endstop: 457.235 # 453.9938
# 261020093505 position_endstop: 457.7303
# position_endstop: 458.2102 # 457.3998
# position_endstop: 457.4764
# position_endstop: 457.2031	 261025115938
# position_endstop: 456.9145	 261104090518
# position_endstop: 456.9897	 261105105446
# position_endstop: 457.2646	 261108155350
# position_endstop: 459.0361	 261110105009
# position_endstop: 458.1079	 261110105715
# position_endstop: 457.8826	 261111110035
position_endstop: 460.0774
position_min: 113
#position_max: 485   # slightly above position_endstop?
step_pin: PB13
dir_pin: PB12
enable_pin: !PB14
microsteps: 16
rotation_distance: 40
# try to have endstops NC, so that they fail triggered, no motion
# if they are wired NO, when a wire comes off, they could crash
endstop_pin: PC0
homing_speed: 20   # mm/s
second_homing_speed: 5
homing_retract_dist: 5
homing_retract_speed: 5

[stepper_b]
# 261019133257 position_endstop: 456.065 # 454.9001
# 261020093505 position_endstop: 456.2678
# position_endstop: 456.0527 # 456.1068
# position_endstop: 455.9504
# position_endstop: 455.9943	 261025115938
# position_endstop: 455.2133	 261104090518
# position_endstop: 455.6082	 261105105446
# position_endstop: 456.0846	 261108155350
# position_endstop: 457.8274	 261110105009
# position_endstop: 457.0560	 261110105715
# position_endstop: 457.0825	 261111110035
position_endstop: 459.4968
#position_max: 480    # slightly above position_endstop
step_pin: PB10
dir_pin: !PB2
enable_pin: !PB11
microsteps: 16
rotation_distance: 40
endstop_pin: PC1
position_min: 112
homing_speed: 20   # mm/s
second_homing_speed: 5
homing_retract_dist: 5
homing_retract_speed: 5

[stepper_c]
# 261019133257 position_endstop: 458.804 # 456.7707
# 261020093505 position_endstop: 459.2586
# position_endstop: 459.5413 # 459.0535
# position_endstop: 459.3283
# position_endstop: 459.3771	 261025115938
# position_endstop: 459.1058	 261104090518
# position_endstop: 459.1516	 261105105446
# position_endstop: 459.5401	 261108155350
# position_endstop: 460.6046	 261110105009
# position_endstop: 460.2863	 261110105715
# position_endstop: 460.4701	 261111110035
position_endstop: 461.7428
#position_max: 460
step_pin: PB0
dir_pin: !PC5
enable_pin: !PB1
microsteps: 16
rotation_distance: 40
endstop_pin: PC2
position_min: 114
homing_speed: 20   # mm/s
second_homing_speed: 5
homing_retract_dist: 5
homing_retract_speed: 5

###  Select current probe type
[include probeMMH0.cfg]  # Mellow MultiHead Zero
#[include probeD2HW.cfg]  # Omron? D2HW-A201D small micro plunger endstop switch
#[include probeBiCQ.cfg]  # BTT? BiQu MicroProbe (retractable)
#[include probeEndstop.cfg]  # endstop microswith as probe
#[include probeKin.cfg]  # Continuity on kinematic mount points as probe

[tmc2209 stepper_a]
uart_pin: PC11
tx_pin: PC10
uart_address: 0
run_current: 0.5 # 0.580
stealthchop_threshold: 999999

[tmc2209 stepper_b]
uart_pin: PC11
tx_pin: PC10
uart_address: 2
run_current: 0.4  # 0.580
stealthchop_threshold: 999999

[tmc2209 stepper_c]
uart_pin: PC11
tx_pin: PC10
uart_address: 1
run_current: 0.4 # 0.580
stealthchop_threshold: 999999

#[delta_calibrate]
#radius: 80

# put this back when we hook up bowden extruder
[extruder]
step_pin: PB3
dir_pin: PB4
enable_pin: !PD2
microsteps: 16
rotation_distance: 6.633  # gearhead rotation << motor rotation
nozzle_diameter: 0.4 # 0.2
filament_diameter: 1.750
heater_pin: PC8
sensor_type: EPCOS 100K B57560G104F
sensor_pin: PA0
control: pid
pid_Kp: 21.527
pid_Ki: 1.063
pid_Kd: 108.982
min_temp: 0
max_temp: 400
min_extrude_temp: 160
#max_extrude_temp: 275
max_extrude_only_distance: 200
max_extrude_only_velocity: 40
max_extrude_only_accel: 1000
max_extrude_cross_section: 2 # 1.0

[tmc2209 extruder]
uart_pin: PC11
tx_pin: PC10
uart_address: 3
run_current: 0.6 # typical is 0.6 to 0.9
stealthchop_threshold: 30
sense_resistor: 0.11  # guess at .11 Ohm sense for 2209 on most BTT boards
hold_current: 0.5
interpolate: True


# uncomment if/when we get a heated bed
#[heater_bed]
#heater_pin: PC9
#sensor_type: ATC Semitec 104GT-2
#sensor_pin: PC3
#control: pid
#pid_Kp: 54.027
#pid_Ki: 0.770
#pid_Kd: 948.182
#min_temp: -200
#max_temp: 3130

[gcode_arcs]
resolution: 0.5 # mm

[heater_fan extruder_fan] # hot end fan
pin: PC6
heater: extruder
heater_temp: 42
kick_start_time: 1

[fan] # part fan
pin: PC7
kick_start_time: 0.5


[mcu]
serial: /dev/serial/by-id/usb-Klipper_stm32f103xe_30FFDA054754343040811557-if00
# serial: /dev/ttyACM0

[force_move]
enable_force_move: True

[static_digital_output usb_pullup_enable]
pins: !PA14

[verify_heater extruder]
max_error: 999999
check_gain_time: 999999
hysteresis: 999999

#[verify_heater heater_bed]
#max_error: 999999
#check_gain_time: 999999
#hysteresis: 999999


[board_pins]
aliases:
    # EXP1 header
    EXP1_1=PB5,  EXP1_3=PA9,   EXP1_5=PA10, EXP1_7=PB8,  EXP1_9=<GND>,
    EXP1_2=PA15, EXP1_4=<RST>, EXP1_6=PB9,  EXP1_8=PB15, EXP1_10=<5V>

[include mainsail.cfg]
[include macroTetra.cfg]
[include macroPRINT_START.cfg]
[include macroDIMPLE_PROBE.cfg]
