Mr-What/Tetra3D/KlipperCfg/macroDIMPLE_PROBE.cfg

### CHANGE TIMESTAMP IN DIMPLE_PROBE after each edit!
#####################################################
# Macros to probe around a dimple fiducial.
# At this time, macros are assumed to be from a 150deg V cutter,
# 15 degree slope sidewalls.

# this needs to be done in macros.
# There is a synchronization problem from regular gcode.
# on 3D prints there is a significant flat area near the bottom
# of the cones. Espessially with 10mm ball-tip probe, we
# get more meaningful data on the sides of the dimples.
# So, for the 150deg dimple plate, it might work better
# to start with a large step, and stop before the probes
# are dominated by slop and noise as opposed to actual probe height.
#
# on printed cal plate, large ball seemed useful below .1mm x-y movement.
#    D2HW mostly useless below .25mm.  It was tracking layers, stair steps.  bottom was flat.
#######################################################################
#  indices are hard coded.
#  accessing jinja arrays by index is easier for synchronization in these macros

[gcode_macro DIMPLE_PROBE_SCALED]
description: scale DX and DY by state variable hex_scale and pass to DIMPLE_PROBE
gcode:
    {% set dx = params.DX|float %}
    {% set dy = params.DY|float %}
    {% set s = printer["gcode_macro _DIMPLE_STATE"] %}
    {% set scl = s.pattern_scale %}
    DIMPLE_PROBE X0={ dx * scl } Y0={ dy * scl }

[gcode_macro DIMPLE_PROBE]
description: Probe neighborhood of dimple near given location
     Move to desired Z height before calling.
gcode:
    {% set X0 = params.X0|float %}
    {% set Y0 = params.Y0|float %}
    {% set DXY0 = 4 %}
    {% set Zup = 8 %}
    {% set r = 4 %}
    {% set rc = r/2 %}  ; different r cor cardinal directions
    {% set m = 0.5359 %} ; 2 * tan(15 degrees) for 150 deg dimple

    TLOG PREFIX="DIMPLE" MSG="{'2610191117 start probe at %.3f, %.3f' % (X0,Y0)}"

    PROBER X={X0 + DXY0} Y={Y0} TAG="1 x+" INDEX=1
    PROBER Y={Y0 + DXY0} X={X0} TAG="2 y+" INDEX=2
    PROBER X={X0 - DXY0} Y={Y0} TAG="3 x-" INDEX=3
    PROBER Y={Y0 - DXY0} X={X0} TAG="4 y-" INDEX=4

    _DIMPLE_UPDATE_VERTEX X0={X0} Y0={Y0}

    {% set c = 0.8660254 %}
    {% set s = 0.5 %}
    {% set rim = [
                  [ rc , 0  ],
	          [ r*c, r*s],
	          [ r*s, r*c],
	          [ 0  , rc ],
	          [-r*s, r*c],
	          [-r*c, r*s],
	          [-rc , 0  ],
	          [-r*c,-r*s],
	          [-r*s,-r*c],
	          [ 0  ,-rc ],
	          [ r*s,-r*c],
	          [ r*c,-r*s]] %}
    {% for i in range(rim|length) %}
        _DIMPLE_UPDATE_NEIGHBOR DX={rim[i][0]} DY={rim[i][1]} INDEX={i+5}
    {% endfor %}

[gcode_macro _DIMPLE_STATE]
description: Internal -- holds persistent scratch variables only, never called directly.
variable_probe: [[-999.9,-999.9,-999.9], [-999.9,-999.9,-999.9],
                 [-999.9,-999.9,-999.9], [-999.9,-999.9,-999.9],
                 [-999.9,-999.9,-999.9], [-999.9,-999.9,-999.9],
                 [-999.9,-999.9,-999.9], [-999.9,-999.9,-999.9],
                 [-999.9,-999.9,-999.9], [-999.9,-999.9,-999.9],
                 [-999.9,-999.9,-999.9], [-999.9,-999.9,-999.9],
                 [-999.9,-999.9,-999.9], [-999.9,-999.9,-999.9],
                 [-999.9,-999.9,-999.9], [-999.9,-999.9,-999.9],
                 [-999.9,-999.9,-999.9], [-999.9,-999.9,-999.9],
                 [-999.9,-999.9,-999.9], [-999.9,-999.9,-999.9],
                 [-999.9,-999.9,-999.9], [-999.9,-999.9,-999.9]]
variable_vertex: [[0.0,0.0,0.0],[0.0,0.0,0.0],[0.0,0.0,0.0],
                  [0.0,0.0,0.0],[0.0,0.0,0.0],[0.0,0.0,0.0],
                  [0.0,0.0,0.0],[0.0,0.0,0.0],[0.0,0.0,0.0]]
variable_pattern_scale : 20
gcode:
    RESPOND PREFIX="DIMPLE" MSG="_DIMPLE_STATE should not be run directly"

[gcode_macro DIMPLE_PROBE_SET]
description: set configuration variables for DIMPLE_PROBE* macros
gcode:
    {% set scale = params.SCALE|float|default(20) %}
    SET_GCODE_VARIABLE MACRO=_DIMPLE_STATE VARIABLE=pattern_scale VALUE={ scale }

[gcode_macro _DIMPLE_CACHE_PROBE]
description: place a probe tiplet at indicated location in cache.
gcode:
    {% set p = printer.probe.last_probe_position %}
    {% set val = [p.x, p.y, p.z] %}
    {% set idx = params.INDEX|int %}
    {% set s = printer["gcode_macro _DIMPLE_STATE"] %}
    {% set cache = s.probe %}
    {% if idx < 0 or idx >= cache|length %}
       {action_raise_error("_DIMPLE_CACHE_PROBE: INDEX %d out of range 0..%d"
                        % (idx, cache|length - 1))}
    {% endif %}
    {% set xo = printer.configfile.settings.probe.x_offset %}
    {% set yo = printer.configfile.settings.probe.y_offset %}
    {% set zo = printer.configfile.settings.probe.z_offset %}
    ; remove offset correction, we want commanded position
    {% set val = [val[0] - xo, val[1] - yo, val[2] + zo] %}
    {% set update = cache[:idx] + [val] + cache[idx + 1:] %}
    SET_GCODE_VARIABLE MACRO=_DIMPLE_STATE VARIABLE=probe VALUE="{update}"
    
[gcode_macro PROBE_REPORT]
description: call this after PROBE to log results.
  This cannot be in the same macro that called PROBE due to synchronization issues
gcode:
    {% set idx = params.INDEX|int %}
    {% set prefix = params.PREFIX|default("DIMPLE") %}
    {% set tag = params.TAG|default("probe") %}
    {% set s = printer["gcode_macro _DIMPLE_STATE"] %}

    {% if idx < 0 or idx >= s.probe|length %}
        {action_raise_error("PROBE_REPORT: INDEX %d out of range" % (idx))}
    {% endif %}

    {% set p = s.probe[idx] %}
    
    TLOG PREFIX="{prefix}" MSG="{' %s\t%.4f, %.4f, %.4f' % (tag,p[0],p[1],p[2])}"

[gcode_macro PROBER]
description: probe and report results
gcode:
    {% set x = params.X|float %}
    {% set y = params.Y|float %}
    {% set idx = params.INDEX|int %}
    {% set prefix = params.PREFIX|default("DIMPLE") %}
    {% set tag = params.TAG|default("probe") %}

    G0 X{x} Y{y} F2000
    PROBE
    _DIMPLE_CACHE_PROBE INDEX={idx}
    PROBE_REPORT PREFIX="{prefix}" TAG="{tag}" INDEX={idx} 
    REL Z={10}

# use sub-macros to synch state variables
[gcode_macro _DIMPLE_UPDATE_VERTEX]
gcode:
    _DIMPLE_SOLVE_3 A=1 B=2 C=3 V=1 X0={params.X0} Y0={params.Y0}
    _DIMPLE_SOLVE_3 A=1 B=2 C=4 V=2 X0={params.X0} Y0={params.Y0}
    _DIMPLE_SOLVE_3 A=1 B=3 C=4 V=3 X0={params.X0} Y0={params.Y0}
    _DIMPLE_SOLVE_3 A=2 B=3 C=4 V=4 X0={params.X0} Y0={params.Y0}
    _DIMPLE_ESTIMATE_VERTEX

[gcode_macro _DIMPLE_ESTIMATE_VERTEX]
description: Combine four 3-point vertex candidates and report 4-point residuals.
gcode:
    {% set state = printer["gcode_macro _DIMPLE_STATE"] %}
    {% set m = 0.2679492 %}
    {% set va = state.vertex[1] %}
    {% set vb = state.vertex[2] %}
    {% set vc = state.vertex[3] %}
    {% set vd = state.vertex[4] %}

    # Candidate slots 1..4.  vertex[0] is the final combined estimate.
    {% set xs = [va[0], vb[0], vc[0], vd[0]]|sort %}
    {% set ys = [va[1], vb[1], vc[1], vd[1]]|sort %}
    {% set zs = [va[2], vb[2], vc[2], vd[2]]|sort %}

    {% set xv = (xs[1] + xs[2]) / 2.0 %}
    {% set yv = (ys[1] + ys[2]) / 2.0 %}
    {% set zv = (zs[1] + zs[2]) / 2.0 %}

    {% set p1 = state.probe[1] %}
    {% set p2 = state.probe[2] %}
    {% set p3 = state.probe[3] %}
    {% set p4 = state.probe[4] %}

    {% set r1 = ((p1[0]-xv)*(p1[0]-xv) + (p1[1]-yv)*(p1[1]-yv))**0.5 %}
    {% set r2 = ((p2[0]-xv)*(p2[0]-xv) + (p2[1]-yv)*(p2[1]-yv))**0.5 %}
    {% set r3 = ((p3[0]-xv)*(p3[0]-xv) + (p3[1]-yv)*(p3[1]-yv))**0.5 %}
    {% set r4 = ((p4[0]-xv)*(p4[0]-xv) + (p4[1]-yv)*(p4[1]-yv))**0.5 %}

    {% set e1 = p1[2] - (zv + m*r1) %}
    {% set e2 = p2[2] - (zv + m*r2) %}
    {% set e3 = p3[2] - (zv + m*r3) %}
    {% set e4 = p4[2] - (zv + m*r4) %}

    {% set es = [e1|abs,e2|abs,e3|abs,e4|abs]|sort %}
    {% set emin = es[0] %}
    {% set emax = es[3] %}
    {% set span = emax - emin %}

    TLOG PREFIX="DIMPLE" MSG="{'V median: X=%.5f Y=%.5f Z=%.5f; candidate span: X=%.5f Y=%.5f Z=%.5f' % (xv, yv, zv, xs[3]-xs[0], ys[3]-ys[0], zs[3]-zs[0])}"
    TLOG PREFIX="DIMPLE" MSG="{'residuals mm: x+=%.5f y+=%.5f x-=%.5f y-=%.5f; span=%.5f' % (e1, e2, e3, e4, span)}"

    ; check for outliers, and re-compute xv,yv,zv after rejecting outliers
    ; this is not very good, but analyse how often it happens and
    ; come up with something better
    {% if es[3] > 2*es[2] %}
        {% if e1|abs == emax %}
	    {% set vv = [vb,vc,vd] %}
	    {% set bad = 1 %}
	{% elif e2|abs == emax %}
	    {% set vv = [va,vc,vd] %}
	    {% set bad = 2 %}
	{% elif e3|abs == emax %}
            {% set vv = [va,vb,vd] %}
	    {% set bad = 3 %}
	{% else %}
	    {% set vv = [va,vb,vc] %}
	    {% set bad = 4 %}
	{% endif %}
        {% set xv = (vv[0][0] + vv[1][0] + vv[2][0]) / 3 %}
        {% set yv = (vv[0][1] + vv[1][1] + vv[2][1]) / 3 %}
        {% set zv = (vv[0][2] + vv[1][2] + vv[2][2]) / 3 %}
        TLOG PREFIX="DIMPLE" MSG="{'rejecting %d mean of remaining %.3f %.3f %.3f'
	    % (bad,xv,yv,zv)}"
    {% endif %}
    _DIMPLE_SET_VERTEX INDEX=0 X={xv} Y={yv} Z={zv}
    PROBER X={xv} Y={yv} tag='0 probe at estimated vertex' INDEX=0
    REL Z=5 F=4000

[gcode_macro _DIMPLE_UPDATE_NEIGHBOR]
gcode:
    {% set dx = params.DX|float %}
    {% set dy = params.DY|float %}
    {% set idx = params.INDEX|int %}
    {% set s = printer["gcode_macro _DIMPLE_STATE"] %}
    {% set cx = s.vertex[0][0] %}
    {% set cy = s.vertex[0][1] %}
    PROBER X={cx+dx} Y={cy+dy} TAG="{'%d neighbor ' % idx}" INDEX={idx}

# shift by [X0,Y0] and solve relative to this instead of [0,0]
# to avoid a round off problem
[gcode_macro _DIMPLE_SOLVE_3]
description: solve for the location of the dimple vertex, given 3 probes
gcode:
    {% set idxA = params.A|default(1)|int %}
    {% set idxB = params.B|default(2)|int %}
    {% set idxC = params.C|default(3)|int %}
    {% set idxV = params.V|default(0)|int %}
    {% set x0 = params.X0|float %}
    {% set y0 = params.Y0|float %}
    {% set m = 0.2679492 %}
    {% set s = printer["gcode_macro _DIMPLE_STATE"] %}

    {% set p1 = s.probe[idxA] %}
    {% set p2 = s.probe[idxB] %}
    {% set p3 = s.probe[idxC] %}

    {% set x1 = p1[0]-x0 %}{% set y1 = p1[1]-y0 %}{% set z1 = p1[2] %}
    {% set x2 = p2[0]-x0 %}{% set y2 = p2[1]-y0 %}{% set z2 = p2[2] %}
    {% set x3 = p3[0]-x0 %}{% set y3 = p3[1]-y0 %}{% set z3 = p3[2] %}

    {% set a1 = z1 / m %}
    {% set a2 = z2 / m %}
    {% set a3 = z3 / m %}

    {% set A2 = x2 - x1 %}
    {% set B2 = y2 - y1 %}
    {% set A3 = x3 - x1 %}
    {% set B3 = y3 - y1 %}

    {% set C2 = ((x2*x2 + y2*y2) - (x1*x1 + y1*y1)
               - (a2*a2 - a1*a1)) / 2.0 %}
    {% set C3 = ((x3*x3 + y3*y3) - (x1*x1 + y1*y1)
               - (a3*a3 - a1*a1)) / 2.0 %}

    {% set D2 = a2 - a1 %}
    {% set D3 = a3 - a1 %}

    {% set det = A2*B3 - A3*B2 %}

    {% set xv = x0 %}  ; set err/default
    {% set yv = y0 %}
    {% set zv = 0  %}
    {% set q = none %}

    {% if det|abs < 0.000001 %}
        TLOG PREFIX="DIMPLE" MSG="_DIMPLE_SOLVE_3: probe points are collinear"
    {% else %}
        {% set xa = (C2*B3 - C3*B2) / det %}
        {% set xb = (-D2*B3 + D3*B2) / det %}
        {% set ya = (A2*C3 - A3*C2) / det %}
        {% set yb = (-A2*D3 + A3*D2) / det %}

        {% set ux = xa - x1 %}
        {% set uy = ya - y1 %}
        {% set qa = xb*xb + yb*yb - 1.0 %}
        {% set qb = 2.0*(xb*ux + yb*uy - a1) %}
        {% set qc = ux*ux + uy*uy - a1*a1 %}
        {% set disc = qb*qb - 4.0*qa*qc %}

        {% if disc < 0.0 %}
            TLOG PREFIX="DIMPLE" MSG="_DIMPLE_SOLVE_3: no real cone solution"
        {% else %}
            {% set root_disc = disc**0.5 %}
            {% if qa|abs < 0.000001 %}
                {% if qb|abs < 0.000001 %}
                    TLOG PREFIX="DIMPLE" MSG="_DIMPLE_SOLVE_3: unstable solution"
	        {% else %}
                    {% set q = -qc/qb %} ; nearly linear
                {% endif %}
	    {% else %}
                {% set q1 = (-qb + root_disc) / (2.0*qa) %}
                {% set q2 = (-qb - root_disc) / (2.0*qa) %}

                # Pick the candidate whose three implied radii are all non-negative.
                {% if a1 + q1 >= 0 and a2 + q1 >= 0 and a3 + q1 >= 0 %}
                    {% set q = q1 %}
                {% elif a1 + q2 >= 0 and a2 + q2 >= 0 and a3 + q2 >= 0 %}
                    {% set q = q2 %}
                {% else %}
                    TLOG PREFIX="DIMPLE" MSG="_DIMPLE_SOLVE_3: no physically valid cone root"
                {% endif %}
            {% endif %}
	{% endif %}
        {% if q is not none %}
            {% set xv = xa + xb*q + x0 %}
            {% set yv = ya + yb*q + y0 %}
            {% set zv = -m*q %}
        {% endif %}
    {% endif %}
    _DIMPLE_SET_VERTEX INDEX={idxV} X={xv} Y={yv} Z={zv}
	
[gcode_macro _DIMPLE_SET_VERTEX]
gcode:
    {% set idx = params.INDEX|int %}
    {% set x   = params.X|float %}
    {% set y   = params.Y|float %}
    {% set z   = params.Z|float %}
    {% set s = printer["gcode_macro _DIMPLE_STATE"] %}
    {% set cache = s.vertex %}
    {% set val = [x, y, z] %}
    {% if idx < 0 or idx >= cache|length %}
       {action_raise_error("_DIMPLE_SET_VERTEX: INDEX %d out of range 0..%d"
                        % (idx, cache|length - 1))}
    {% endif %}
    {% set update = cache[:idx] + [val] + cache[idx + 1:] %}
    SET_GCODE_VARIABLE MACRO=_DIMPLE_STATE VARIABLE=vertex VALUE="{update}"
    TLOG PREFIX="DIMPLE" MSG="{'%d computed vertex: %.3f, %.3f, %.3f' % (idx, x, y, z)}"
