Mr-What/Tetra3D/(commit log)

2019-07-23 copied over from older kossel project stuff. Instead of working as a new modification to kossel, start new project for tetrahedral
    [ext15ob.scad, ext20v.scad, nema17.scad, tiltedDelta.scad]
2019-07-24 taken from kossel
    [configuration.scad]
2019-07-24 moved vertex down
    [tiltedDelta.scad]
2019-07-25 set standard coords from leg lengths
2019-07-25 change to have defining parameters base leg lengths, and apex point
2019-07-26 plots an example of a tetra printer model
2019-07-27 return servo positions
2019-07-29 added holes for ties on vertex
    [tiltedDelta.scad]
2019-07-30 checking in before changing model a bit
    [ext20.scad]
2019-07-30 hi-fi when no fuzz, for 3D/laser cut-outs when fuzz nonzero
    [ext20.scad]
2019-07-30 went to non-v-slot extrusion towers
    [tiltedDelta.scad]
2019-07-31 minor changes. checking in before significant iteration
    [tiltedDelta.scad]
2019-08-01 made vertex bigger
    [tiltedDelta.scad]
2019-08-01 oops. didn't trim as much of extrusion slot area as needed.
    [tiltedDelta.scad]
2019-08-01 tweaked fuzz adjustments. Made slot insert less than wall thickness
    [ext20.scad]
2019-08-01 mitsumi 15mm extrusion model
    [tiltedDelta.scad]
2019-08-02 wider base
    [tiltedDelta.scad]
2019-08-03 reduced size of cut-out in apex
    [tiltedDelta.scad]
2019-08-04 made vertex thicker
    [tiltedDelta.scad]
2019-08-04 made vertex a little longer
    [tiltedDelta.scad]
2019-08-12 Compute and show heights from table to assist in construction of frame with caliper shrink pad on end of 15mm extrusions a bit add nut insertion holes for 15mm extrusions shrink tabs on tower slots i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
    [tiltedDelta.scad]
2019-08-17 square nut insertion holes, in case using square nuts moved utility strap holes to avoid overhang to plate
    [tiltedDelta.scad]
2026-02-20 tetra2cart worked for tyrivial case
2026-02-21 note 15 parameter implementation
    Added some text to reflect that current model IS the desired 15 parameter model described. The single Apex model was asserted in circa 2018 model.
2026-02-25 more test scripts, new drawings
    [endstop20v.scad, holes.scad, microswitch.scad, switchEndstop20v.stl, tiltedDelta.scad]
2026-03-14 changed parameters to be closer to classic linear delta kinematics
    [bedClip.scad, endstop20v.scad, idlerMount.scad, tiltedDelta.scad]
2026-03-24 updated drawings and tetra kinematics
    [bedClip.stl, beltCatch.scad, endstop.scad, ext20v.scad, frogCarriage.scad, frogCarriage20v.scad, rodMountHorn.scad, switchEndstop20v.stl]
2026-04-12 refactor parameter names, add AI printer.cfg merge
2026-04-16 demonstrated two stage refinement
2026-04-17 new utility to load klipper .cfg files
    [printer.cfg]
2026-05-06 initial calibration
2026-05-09 cal updates for printer.cfg, new extruder cold-end drawing
    [gearheadExtruder.scad, printer.cfg]
2026-05-11 minor tweaks to improve printing
    [gearheadExtruder.scad]
2026-05-26 working on kinematic and tap toolhead
    [SKR_Mini_E3_v2.scad, gearheadExtruder.scad, hotEnd.scad, kinematicMount.scad, notVoronTap.scad, printer.cfg, util.scad]
2026-06-01 stronger fan mount
    [kinematicMount.scad, util.scad]
2026-06-10 changed horn brace and outerBrace to hex and pent
    [kinematicMount.scad]
2026-06-27 added removable switch probe
    [kinematicMount.scad]
2026-07-15 revised drawings and started NOTES.md
    [blower4020.scad, endstop20v.scad, hotEnd.scad, kinematicMount.scad, kinematicProbe.scad, partFanMounts.scad, switchMount.scad, util.scad]
2026-07-22 notes update and new idler
    [BoostConverterBox.scad, cableTie.scad, tensionIdler.scad]
2026-07-30 part way to some new cal code. update some drawings for probes
    [kinematicProbe.scad, microswitch.scad]
2026-07-30 change name to distinguish from standard klipper bed-compensation bed probe
2026-08-30 new mount for BTT V2 microprobe
    [kinematicProbe.scad, microprobe_v2_mockup.stl]
2026-08-31 drawings for kinematic mount of new sensors
    [D2HW.scad, kinMMZmount.stl, kinMicroprobe.stl, kinMountBTTmicroprobeV2.scad, kinematicProbe.scad, mellowMultiheadZero.scad]
2026-09-13 corrected probe offset handling
    [deltaCalPrint.scad, printer.cfg, probeEndstop.cfg, probeMMH0.cfg, tetraMacros.cfg]
2026-09-18 cal seems to be working as desired
    [D2HW.scad, kinematicProbe.scad, printer.cfg, probeMMH0.cfg, tensionIdler.scad, tetraMacros.cfg, util.scad]
2026-09-21 check in before tool refactor
    [kinMMZmount.stl, microswitch.scad, tensionIdler.scad, tiltedDelta.scad]
2026-09-23 refactoring some names, new plots
    [mainsail.cfg, printer.cfg, probeD2HW.cfg, tetraMacros.cfg]
2026-10-01 some refactoring, PROBE_FIDUCIAL added
    [macroPRINT_START.cfg, macroPROBE_FIDUCIAL.cfg, printer.cfg, tetraMacros.cfg]
2026-10-02 more refactor, and start of fiducial probe estimation
2026-10-02 initial fiducial probe
    [macroPRINT_START.cfg, macroPROBE_FIDUCIAL.cfg, tetraMacros.cfg]
2026-10-04 got cal plate probe and load running
    [macroPROBE_FIDUCIAL.cfg, printer.cfg, tetraMacros.cfg]
2026-10-05 loading and estimating dimple vertices
    [calPlate.scad, kinematicMount.scad, macroPROBE_FIDUCIAL.cfg, tetraMacros.cfg]
2026-10-09 got new DIMPLE_PROBE running
    [macroDIMPLE_PROBE.cfg, macroPROBE_FIDUCIAL.cfg, printer.cfg, probeMMH0.cfg, tetraMacros.cfg]
2026-10-09 promoting KlipperCfg to be a top level directory
    [macroDIMPLE_PROBE.cfg, macroPRINT_START.cfg, macroPROBE_FIDUCIAL.cfg, mainsail.cfg, printer.cfg, probeD2HW.cfg, probeEndstop.cfg, probeMMH0.cfg]
2026-10-09 analysis of simpler ring neighbor probe runs
2026-10-10 load and vertex estimate for cal plate probes running
    [macroDIMPLE_PROBE.cfg]
2026-10-11 collect code to load cal plate probe, and more refactoring to new naming conventions
2026-10-16 load and fits of dimple probe data running
2026-10-16 calibration running with new metrics
